proctorsdp/breathStrummer/Screenshots/110_STRUMMER_ISOMETRIC.JPG

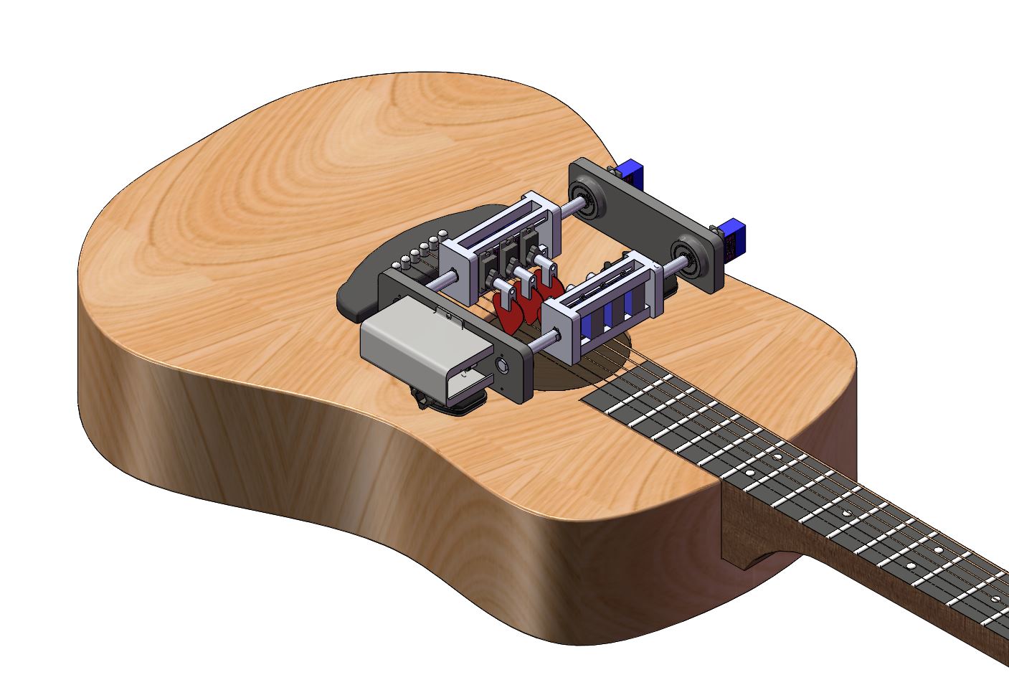
Screenshots/110_STRUMMER_ISOMETRIC.JPG
