proctorsdp/breathStrummer/Screenshots/110_STRUMMER_SIDE_OPAQUE.JPG

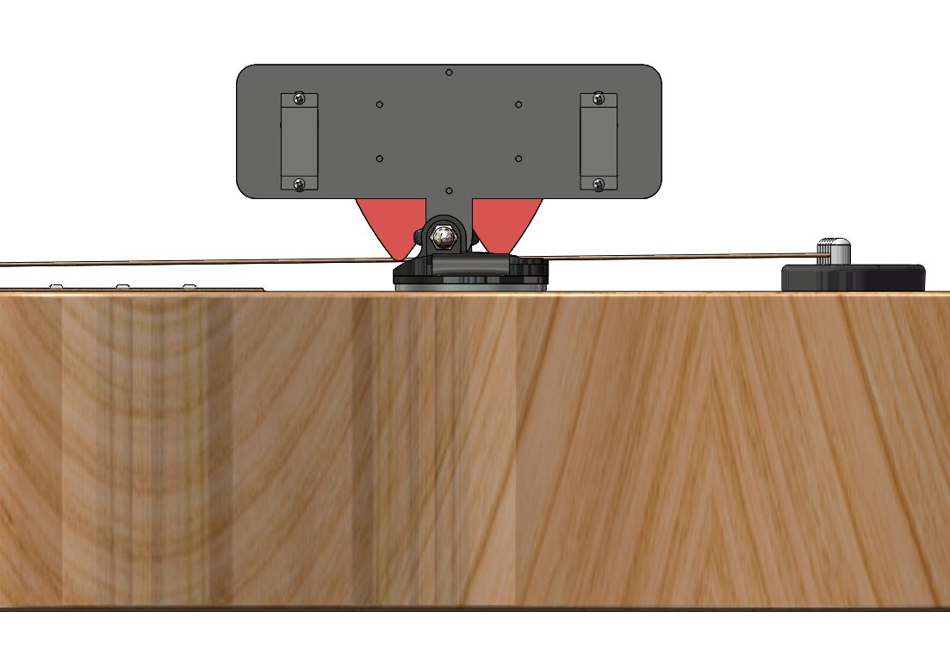
Screenshots/110_STRUMMER_SIDE_OPAQUE.JPG
