proctorsdp/breathStrummer/Drawings/110_STRUMMER_ARRAY_EXPLODED.JPG

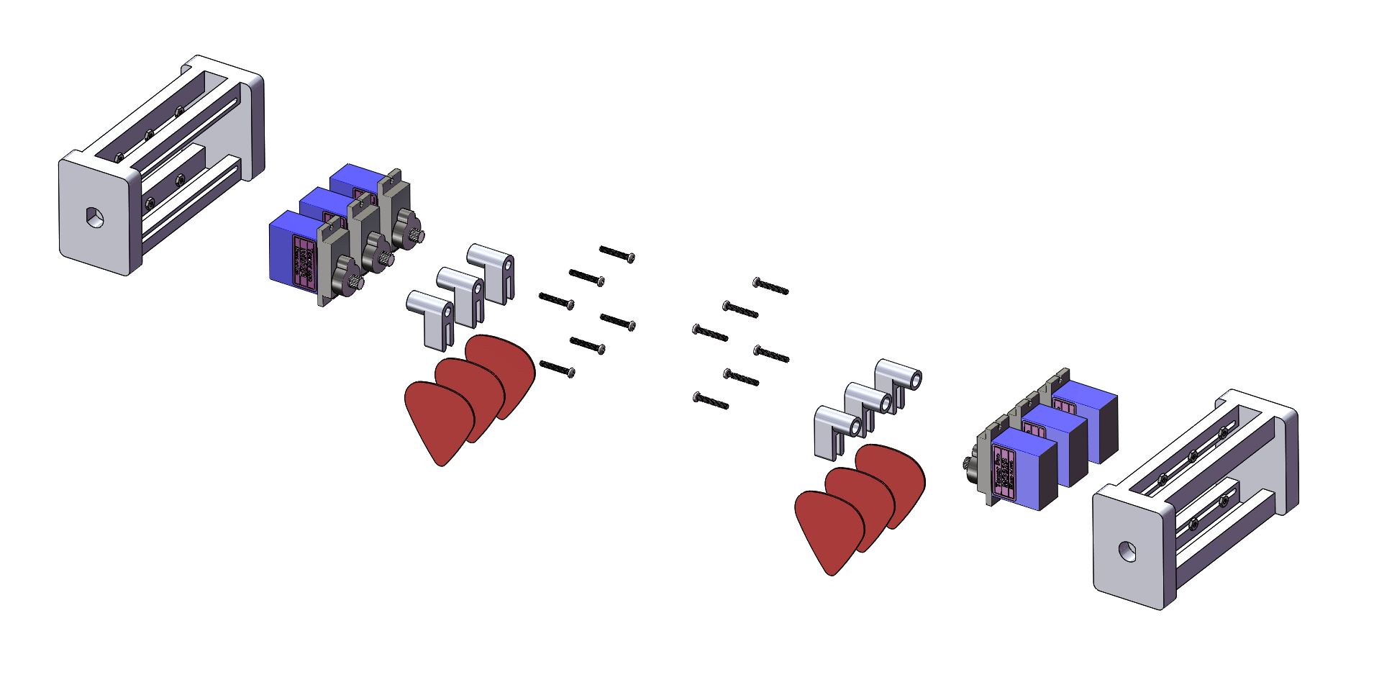
Drawings/110_STRUMMER_ARRAY_EXPLODED.JPG
