proctorsdp/breathStrummer/Drawings/110_STRUMMER_EXPLODED.JPG

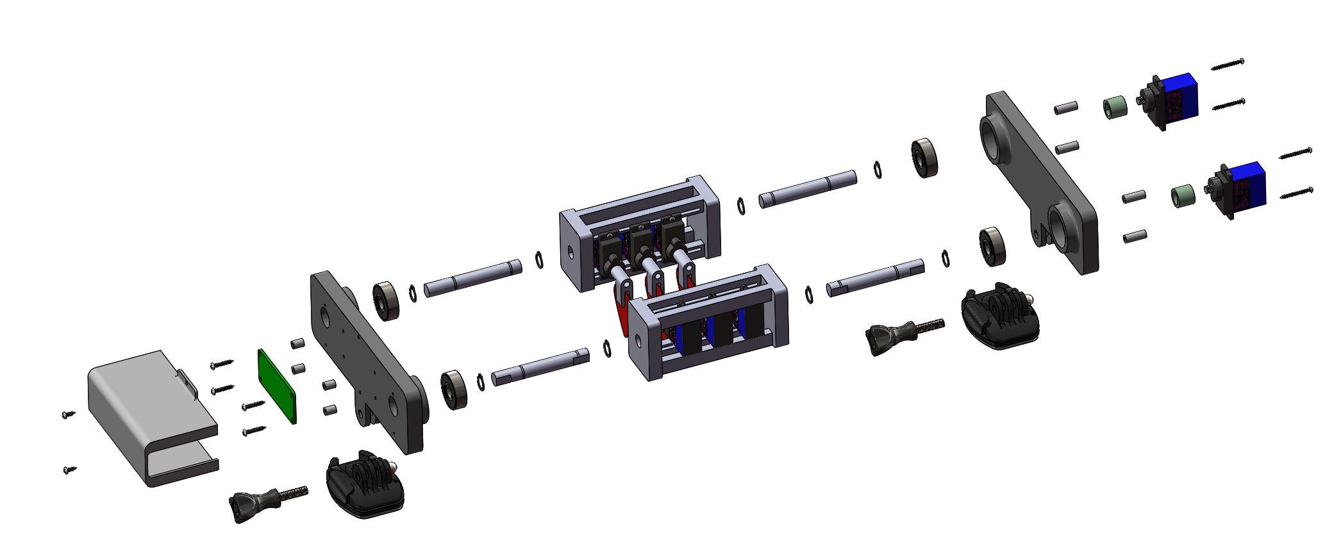
Drawings/110_STRUMMER_EXPLODED.JPG
