proctorsdp/breathStrummer/Drawings/120_MOUTHPIECE_EXPLODED.JPG

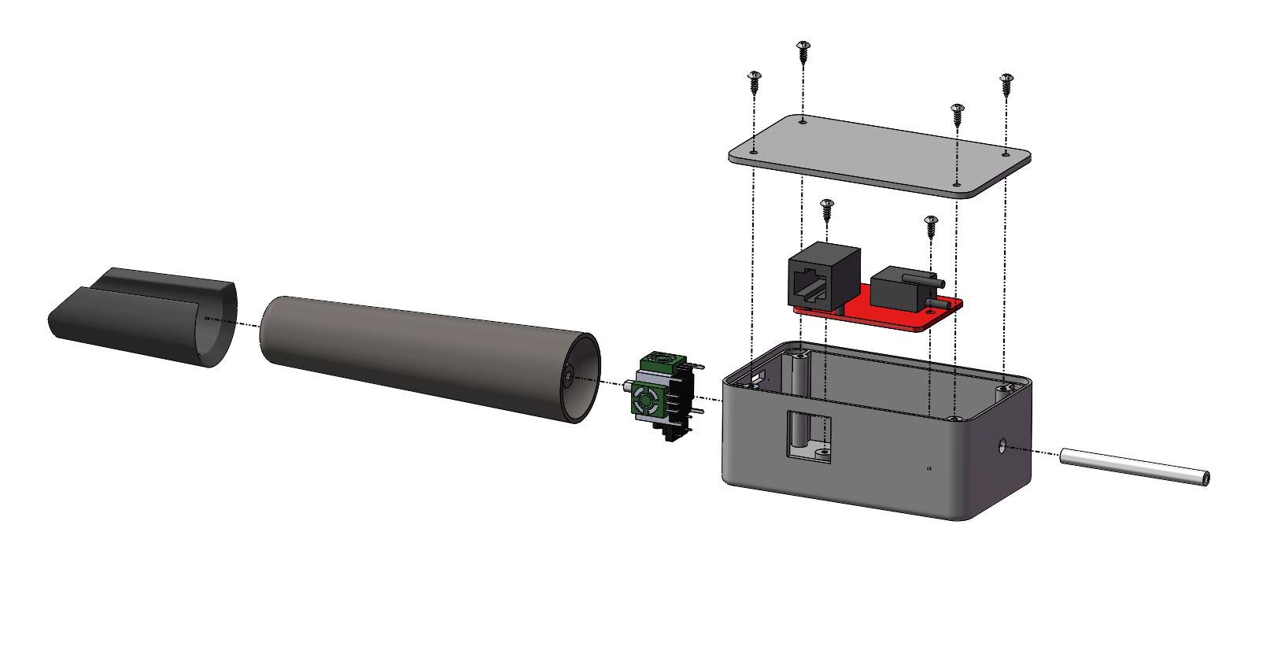
Drawings/120_MOUTHPIECE_EXPLODED.JPG
