proctorsdp/breathStrummer/Screenshots/110_STRUMMER_ISOMETRIC_CLOSE_UP.JPG

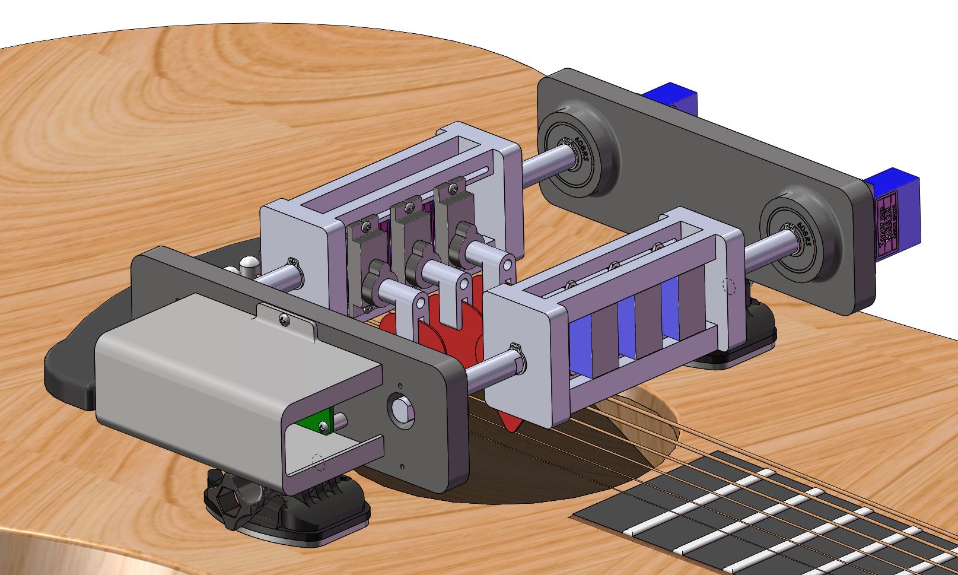
Screenshots/110_STRUMMER_ISOMETRIC_CLOSE_UP.JPG
