proctorsdp/breathStrummer/Screenshots/110_STRUMMER_SIDE_TRANSPARENT.JPG

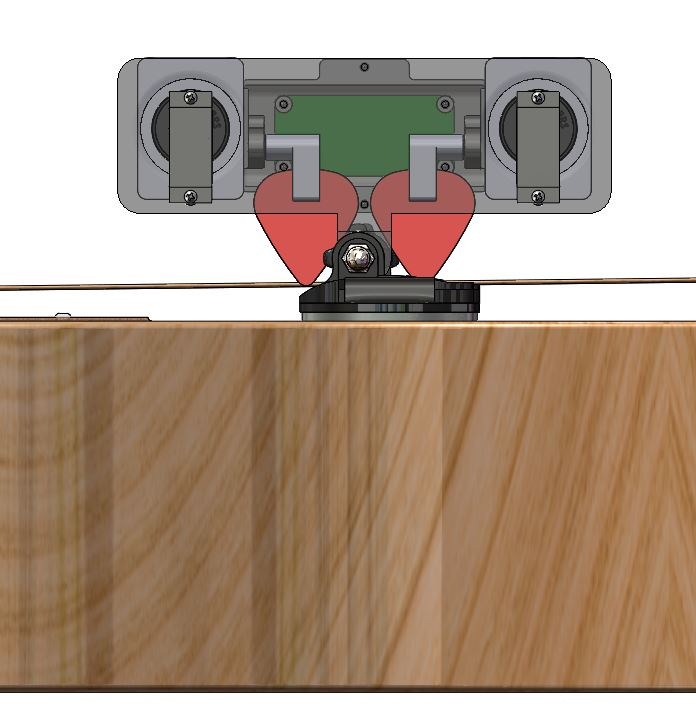
Screenshots/110_STRUMMER_SIDE_TRANSPARENT.JPG
