proctorsdp/breathStrummer/Screenshots/111_LEG_SUPPORT_ISOMETRIC.JPG

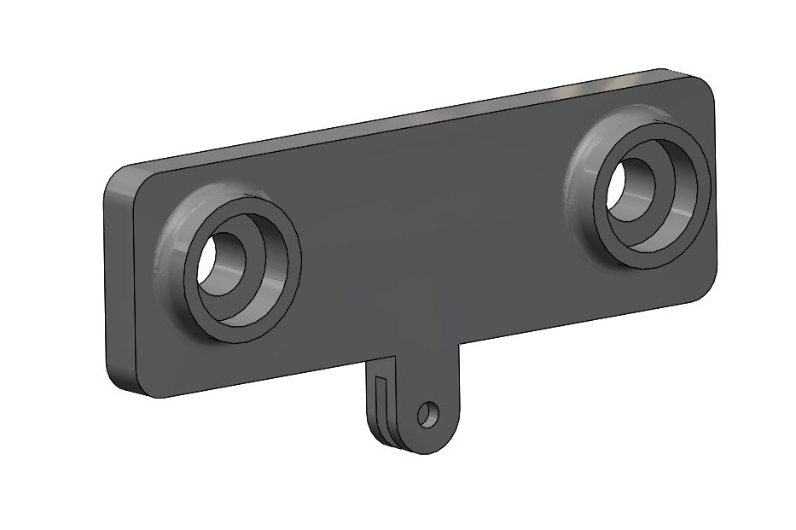
Screenshots/111_LEG_SUPPORT_ISOMETRIC.JPG
