proctorsdp/breathStrummer/Screenshots/112_LEG_SUPPORT_ISOMETRIC.JPG

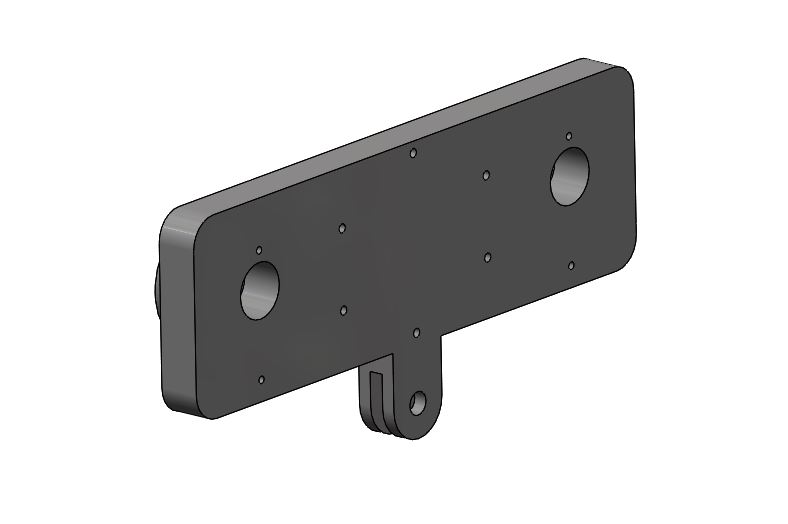
Screenshots/112_LEG_SUPPORT_ISOMETRIC.JPG
