proctorsdp/breathStrummer/Screenshots/113_SERVO_ARRAY_ISOMETRIC.JPG

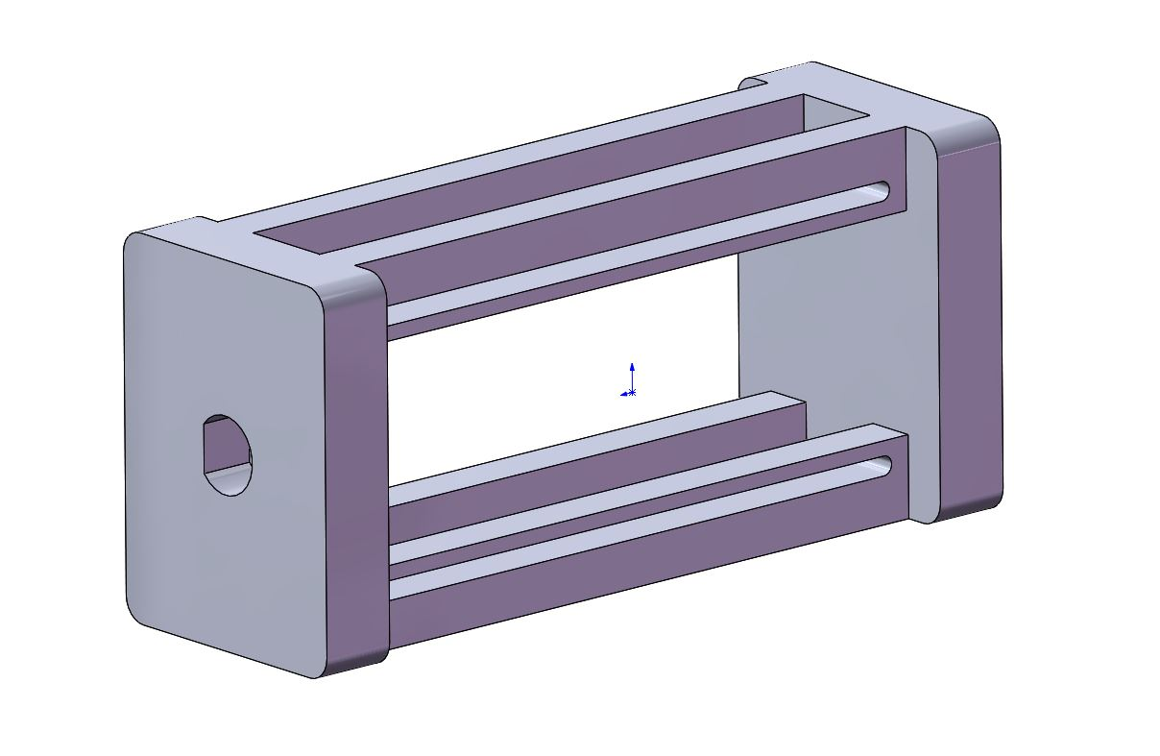
Screenshots/113_SERVO_ARRAY_ISOMETRIC.JPG
