proctorsdp/breathStrummer/Screenshots/114_PICK_HOLDER_ISOMETRIC.JPG

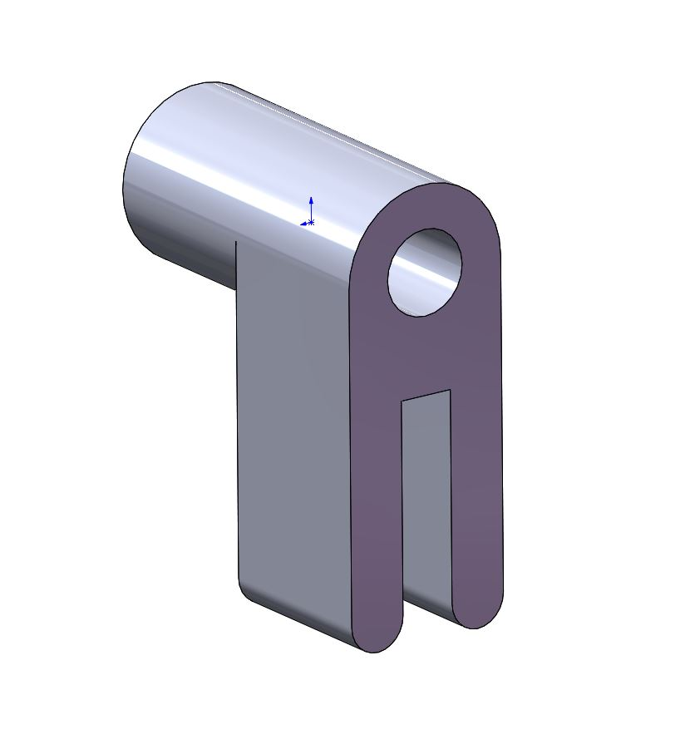
Screenshots/114_PICK_HOLDER_ISOMETRIC.JPG
