proctorsdp/breathStrummer/Screenshots/115_D_SHAFT_ISOMETRIC.JPG

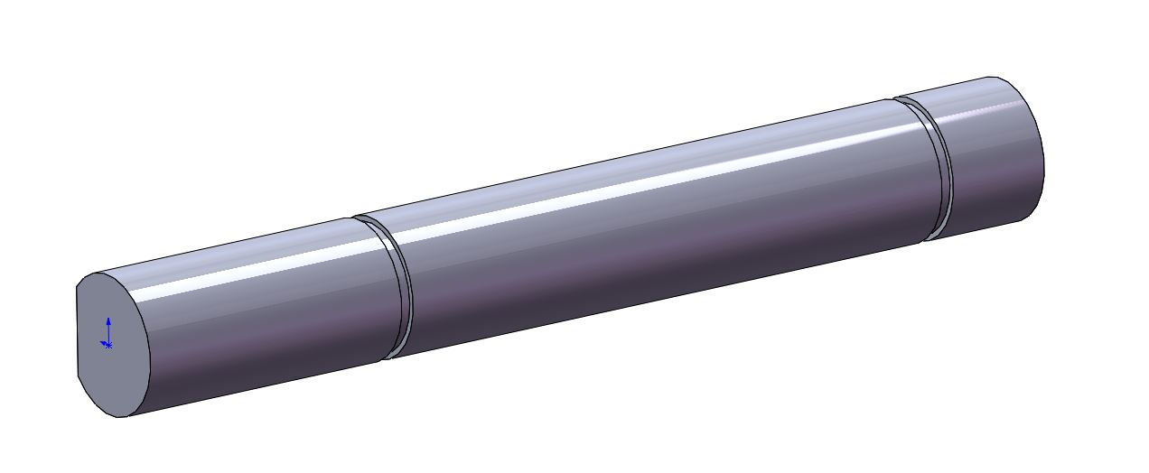
Screenshots/115_D_SHAFT_ISOMETRIC.JPG
