proctorsdp/breathStrummer/Screenshots/116_COVER_MICROPROCESSOR.JPG

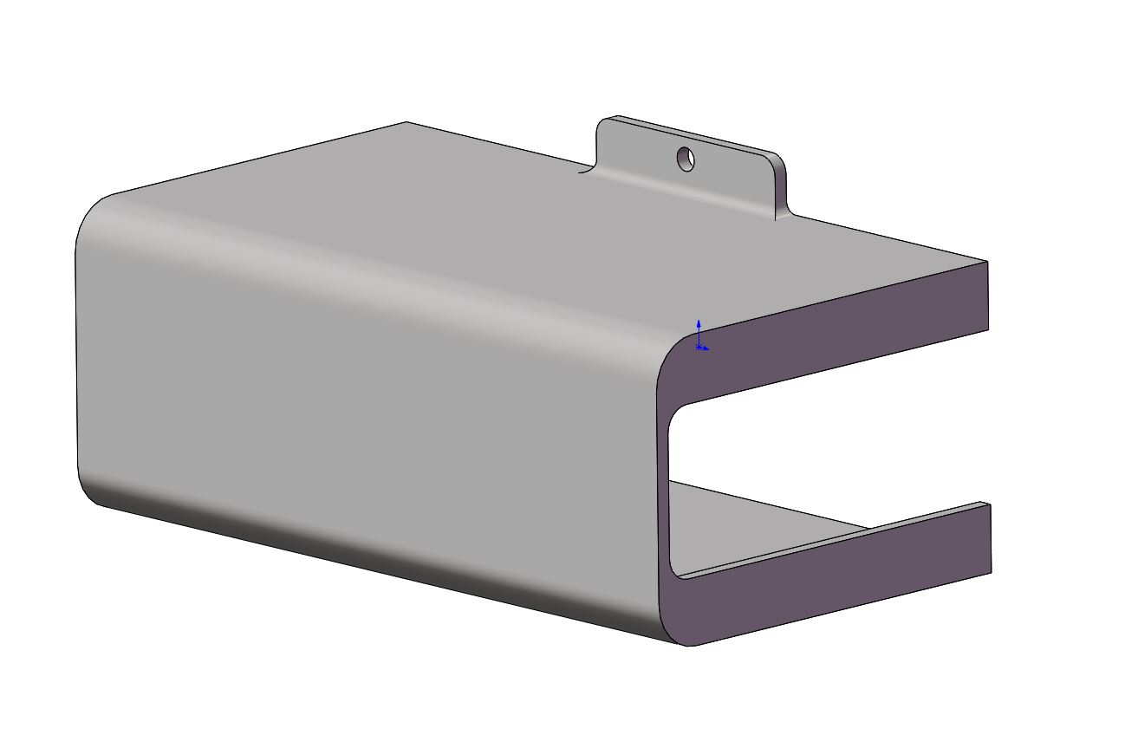
Screenshots/116_COVER_MICROPROCESSOR.JPG
