proctorsdp/breathStrummer/Screenshots/117_ROD_ADAPTER.JPG

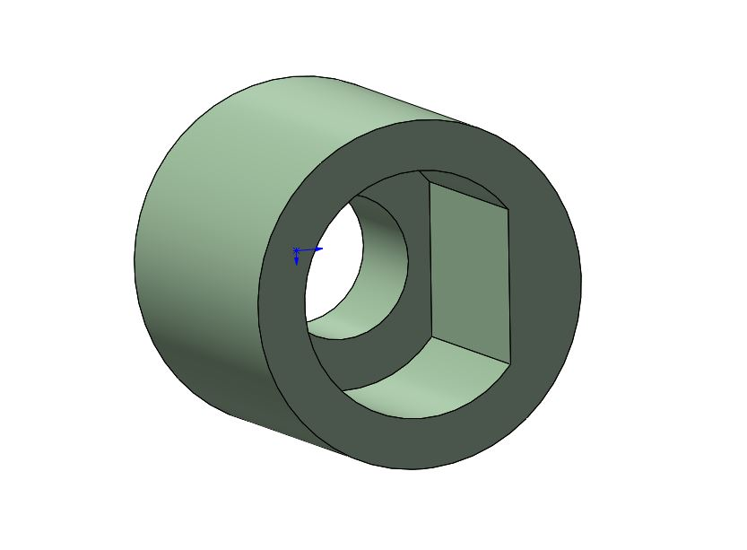
Screenshots/117_ROD_ADAPTER.JPG
