proctorsdp/breathStrummer/Screenshots/120_MOUTHPIECE_ISOMETRIC.JPG

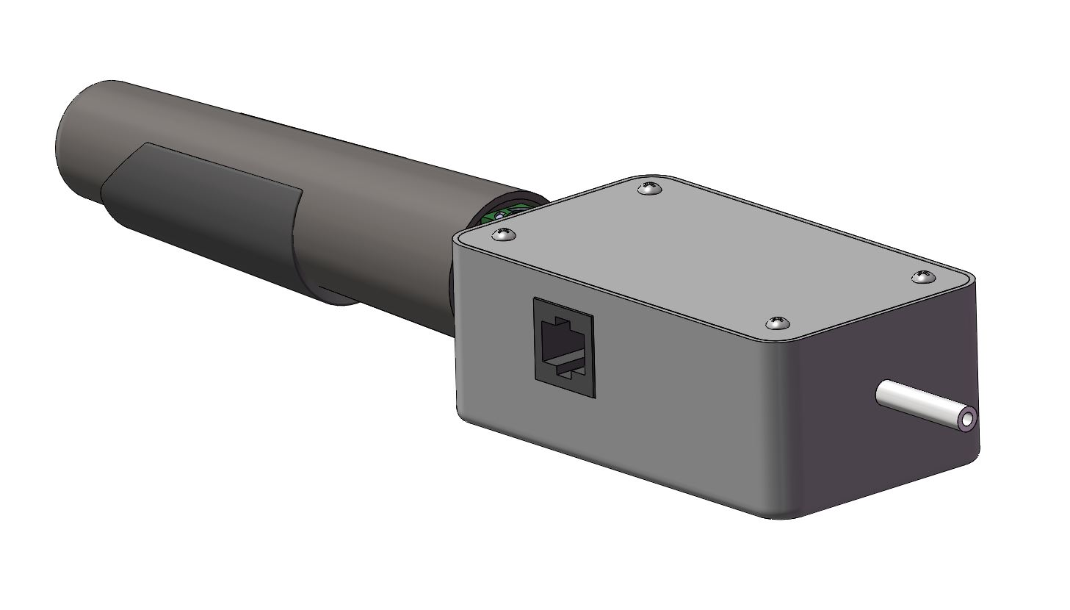
Screenshots/120_MOUTHPIECE_ISOMETRIC.JPG
