proctorsdp/breathStrummer/Screenshots/120_MOUTHPIECE_ISOMETRIC_TRANPARENT.JPG

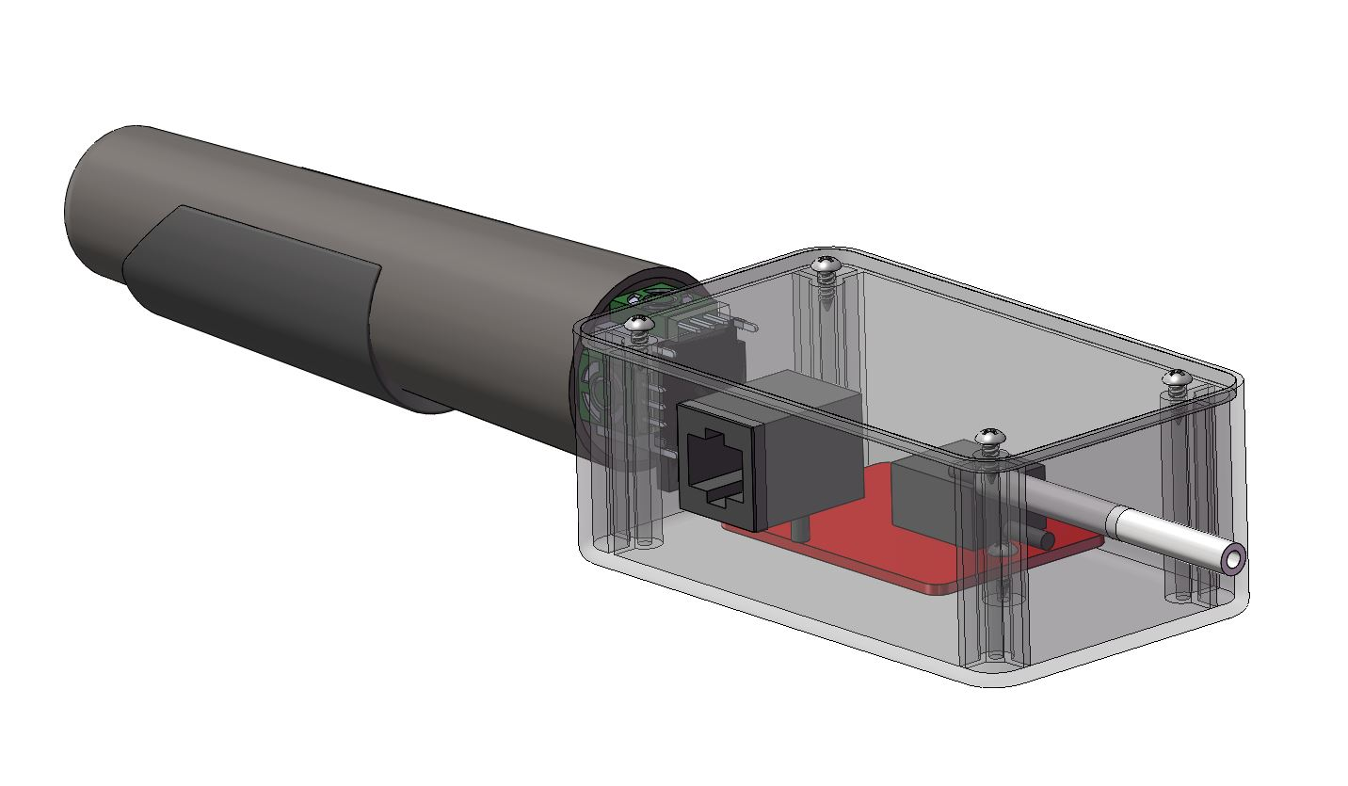
Screenshots/120_MOUTHPIECE_ISOMETRIC_TRANPARENT.JPG
