proctorsdp/breathStrummer/Screenshots/120_MOUTHPIECE_SIDE_TRANSPARENT.JPG

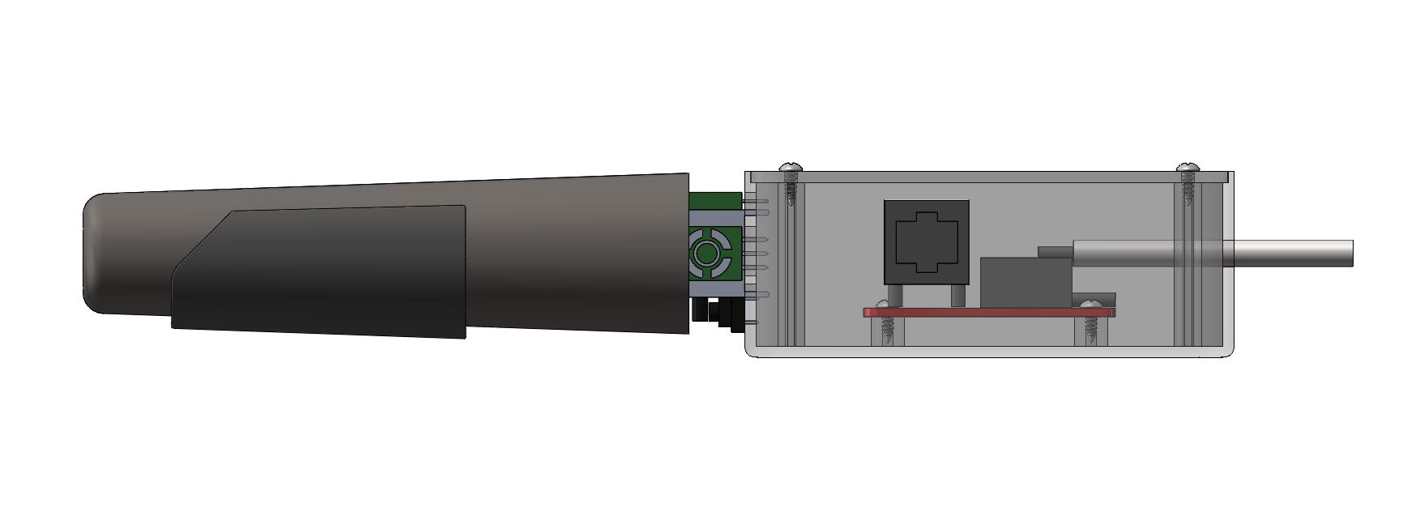
Screenshots/120_MOUTHPIECE_SIDE_TRANSPARENT.JPG
