proctorsdp/breathStrummer/Screenshots/121_HOUSING_BASE.JPG

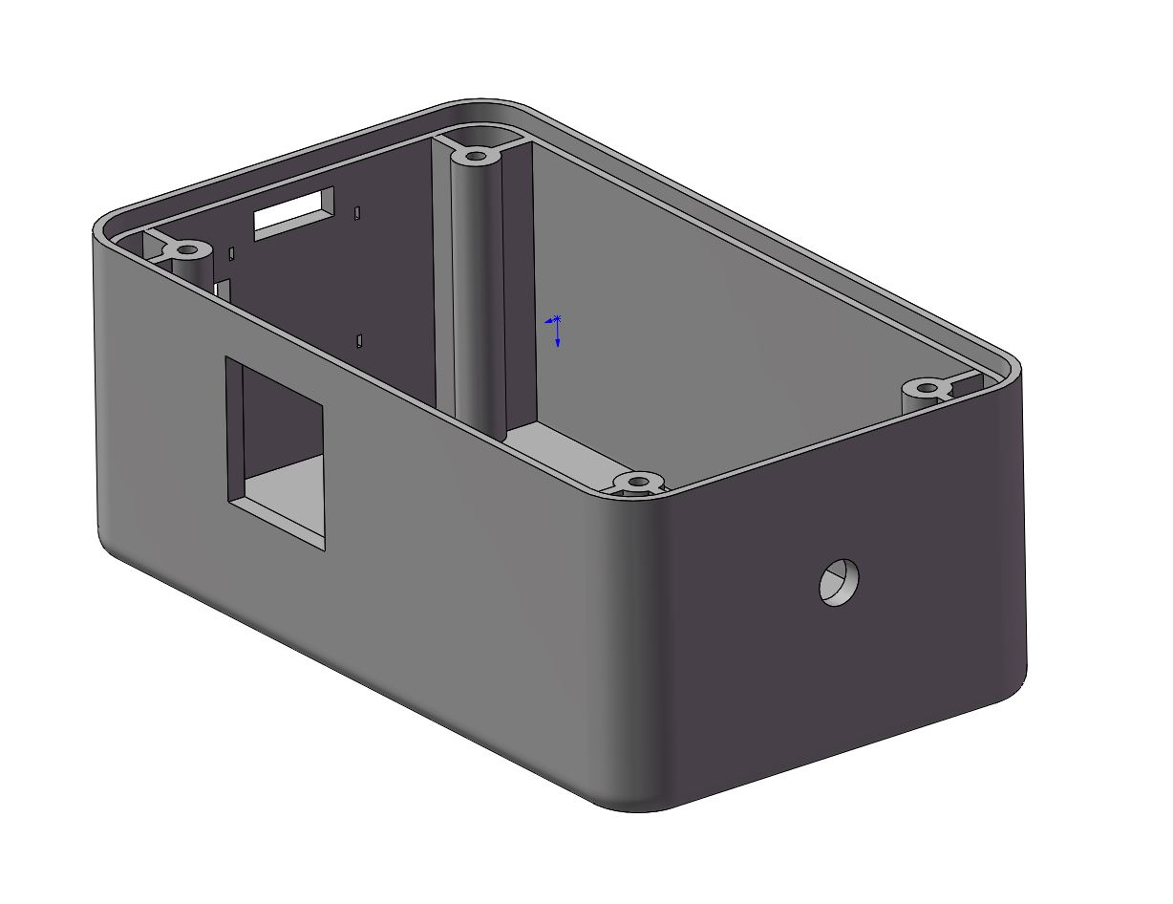
Screenshots/121_HOUSING_BASE.JPG
