proctorsdp/breathStrummer/Screenshots/122_HOUSING_LID.JPG

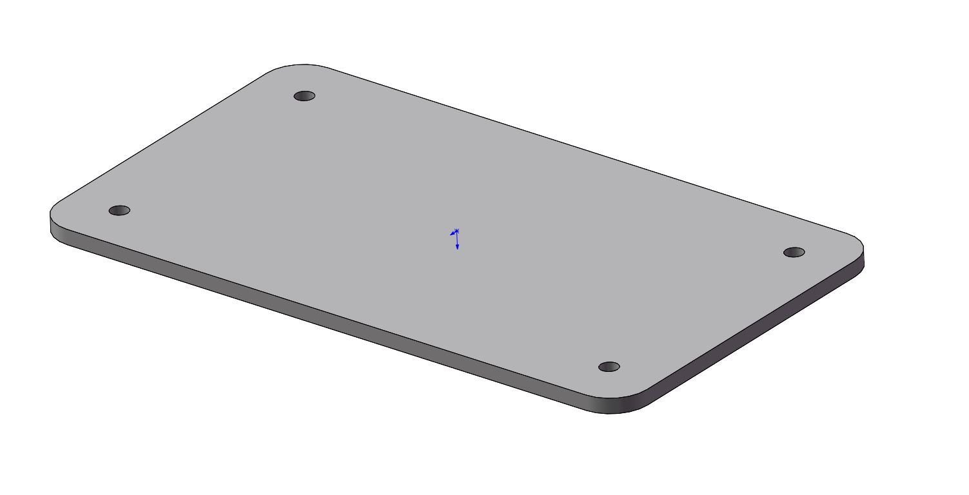
Screenshots/122_HOUSING_LID.JPG
