proctorsdp/breathStrummer/Screenshots/123_MICROPHONE_MOUNT.JPG

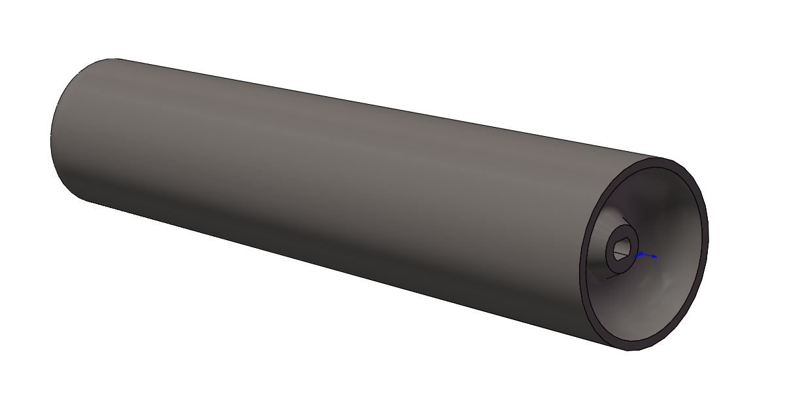
Screenshots/123_MICROPHONE_MOUNT.JPG
