proctorsdp/breathStrummer/Solid Works/Strummer/GoPro_Quick_Release_Buckle.sldasm

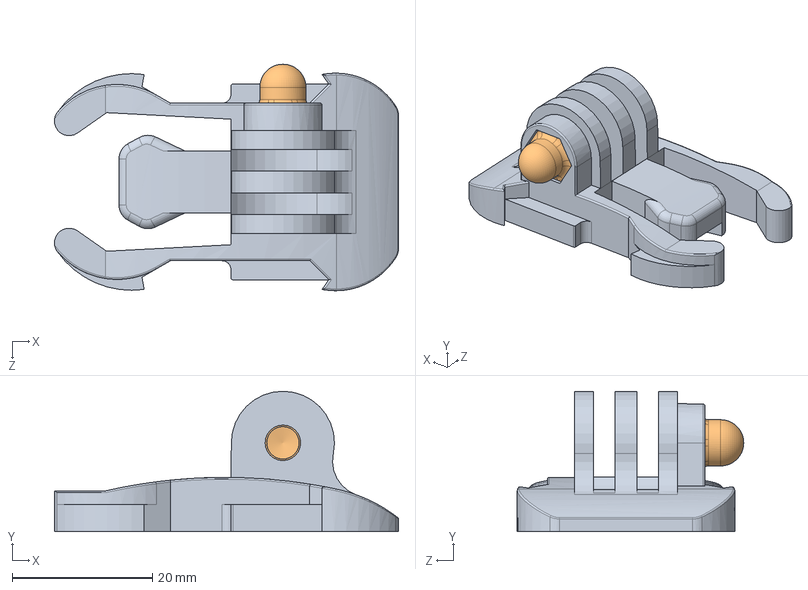
[picture p28: CAD file, 2017-12-18]
Solid Works/Strummer/GoPro_Quick_Release_Buckle.sldasm
49.1 x 20.1 x 32.4 mm
GoPro_Quick_Release_Buckle
GoPro_Nut
