proctorsdp/breathStrummer/Solid Works/Strummer/110_STRUMMER.SLDASM

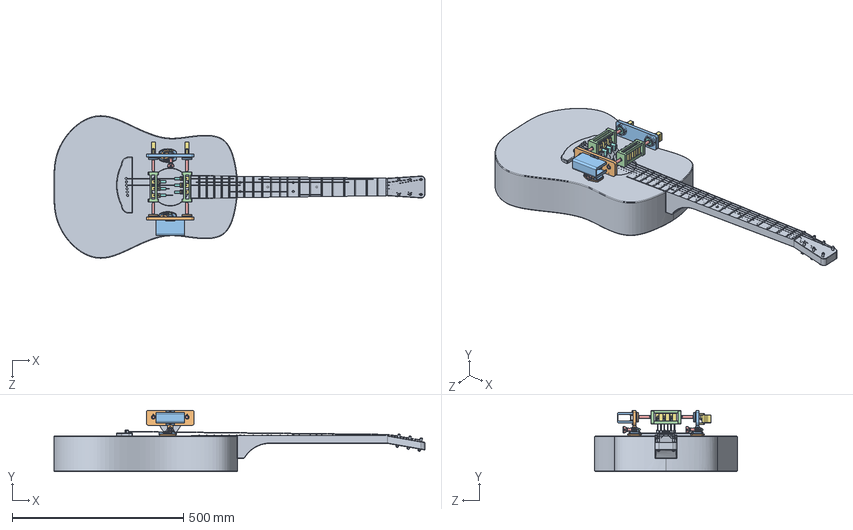
[picture p29: CAD file, 2017-12-18]
Solid Works/Strummer/110_STRUMMER.SLDASM
1082.9 x 179.5 x 416.2 mm
GUITAR_ACOUSTIC
GoPro_Adhesive_Base x 2
GoPro_Quick_Release_Buckle x 2
GoPro_Nut x 2
GoPro_Thumbscrew_Plastic_Short x 2
GoPro_Thumbscrew_Screw_Short x 2
MG92B_servo x 8
114_PICK_HOLDER x 6
GUITAR_PICK_6MM x 6
111_LEG_SUPPORT
112_LEG_SUPPORT
113_SERVO_ARRAY x 2
115_D_SHAFT x 4
91772A070_18-8 SS PAN HEAD PHILLIPS MACHINE SCREW x 12
91841A125_TYPE 18-8 STAINLESS STEEL HEX NUT x 12
SKATEBOARD_BEARING x 4
117_ROD_ADAPTER x 2
ADAFRUIT_FEATHER
116_COVER_MICROPROCESSOR
94639A705_NYLON UNTHRD SPACERS x 4
92470A098_PAN HEAD PHILLIPS SCREW FOR SHEET METAL x 4
92470A065_PAN HEAD PHILLIPS SCREW FOR SHEET METAL x 4
94639A713_NYLON UNTHRD SPACERS x 4
98410A115_EXTERNAL RETAINING RING x 8
92470A095_PAN HEAD PHILLIPS SCREW FOR SHEET METAL x 2
