proctorsdp/breathStrummer/Solid Works/Mouthpiece/MICROPHONE_CLIP.SLDPRT

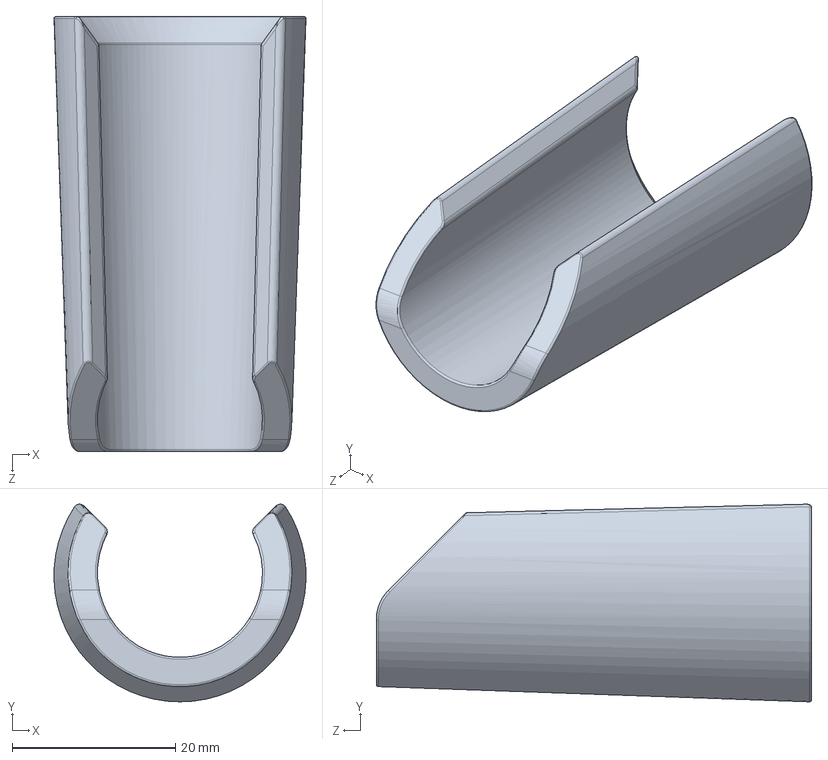
[picture p30: CAD file, 2017-12-18]
Solid Works/Mouthpiece/MICROPHONE_CLIP.SLDPRT
30.9 x 24.3 x 53.4 mm
