proctorsdp/breathStrummer/STL Files/Mouthpiece/122_HOUSING_LID.STL

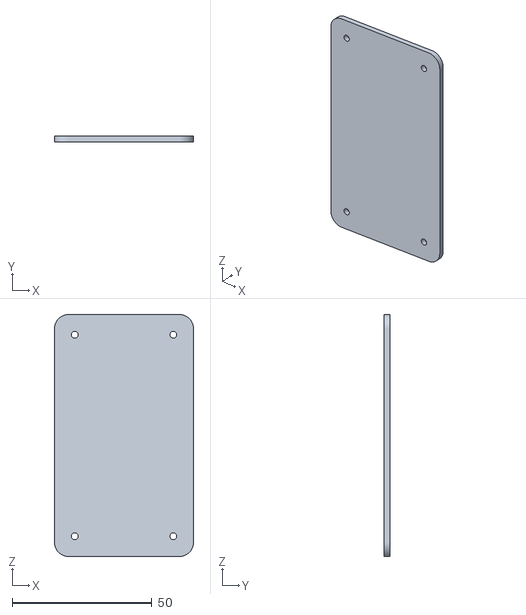
[picture p31: CAD file, 2017-12-18]
STL Files/Mouthpiece/122_HOUSING_LID.STL
49.8 x 2.03 x 86.6
