proctorsdp/breathStrummer/STL Files/Strummer/112_LEG_SUPPORT.STL

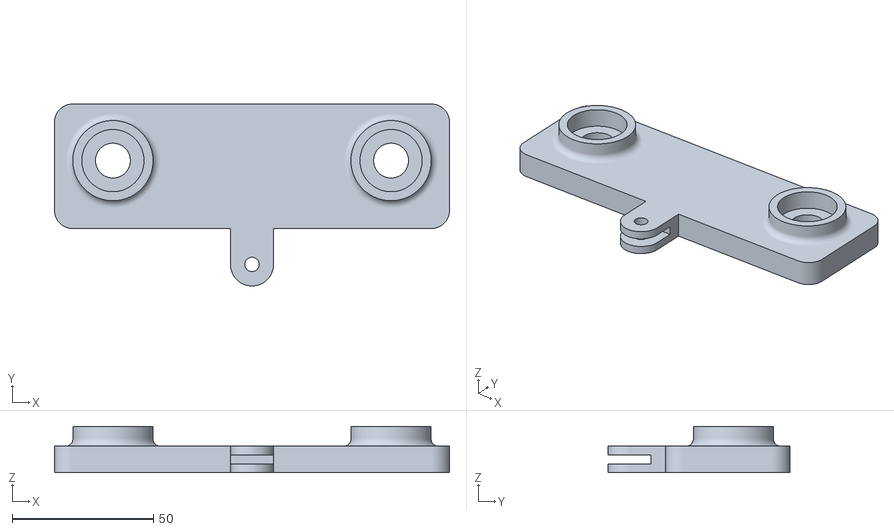
[picture p32: CAD file, 2017-12-18]
STL Files/Strummer/112_LEG_SUPPORT.STL
139.7 x 64.3 x 16.3
