proctorsdp/breathStrummer/Solid Works/Mouthpiece/TUBE.SLDPRT

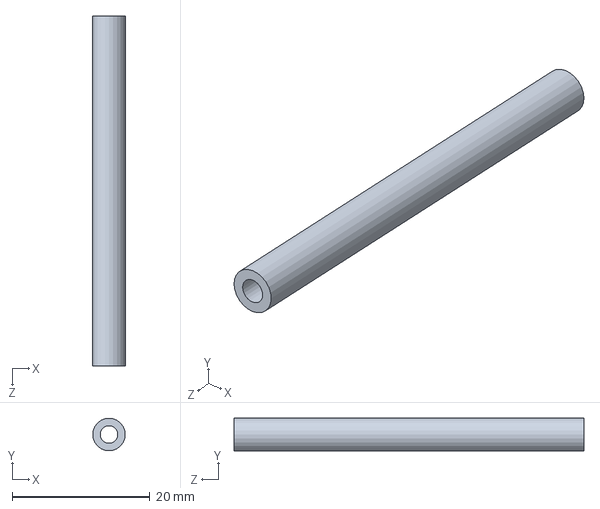
[picture p33: CAD file, 2017-12-18]
Solid Works/Mouthpiece/TUBE.SLDPRT
4.72 x 4.72 x 50.8 mm
