proctorsdp/breathStrummer/Solid Works/Strummer/GUITAR_PICK_6MM.SLDPRT

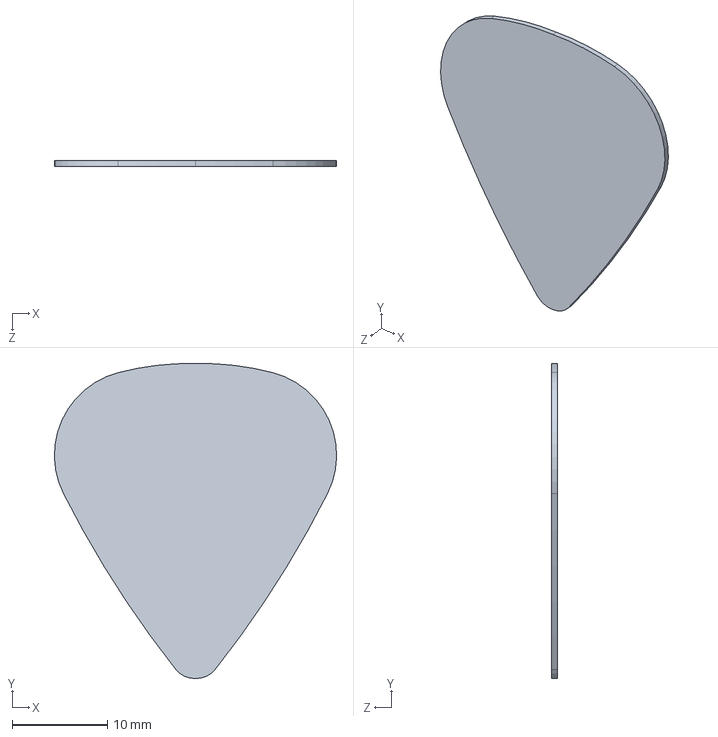
[picture p34: CAD file, 2017-12-18]
Solid Works/Strummer/GUITAR_PICK_6MM.SLDPRT
29.6 x 33.0 x 0.6 mm
