proctorsdp/breathStrummer/STL Files/Mouthpiece/121_HOUSING_BASE.STL

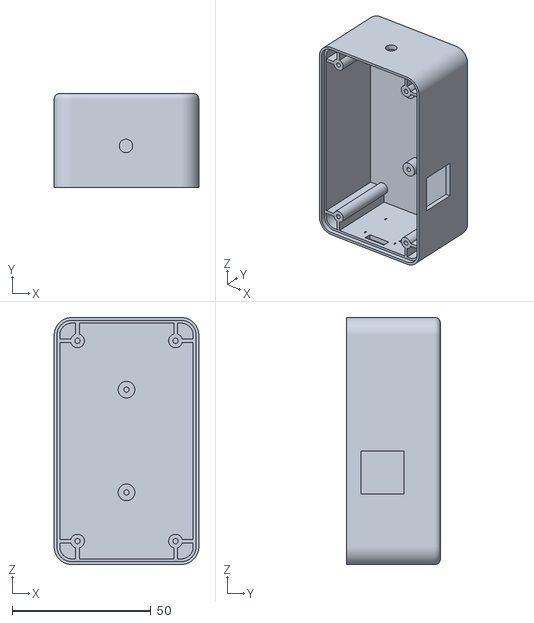
[picture p35: CAD file, 2017-12-18]
STL Files/Mouthpiece/121_HOUSING_BASE.STL
52.1 x 33.8 x 88.9
