proctorsdp/breathStrummer/STL Files/Strummer/114_PICK_HOLDER.STL

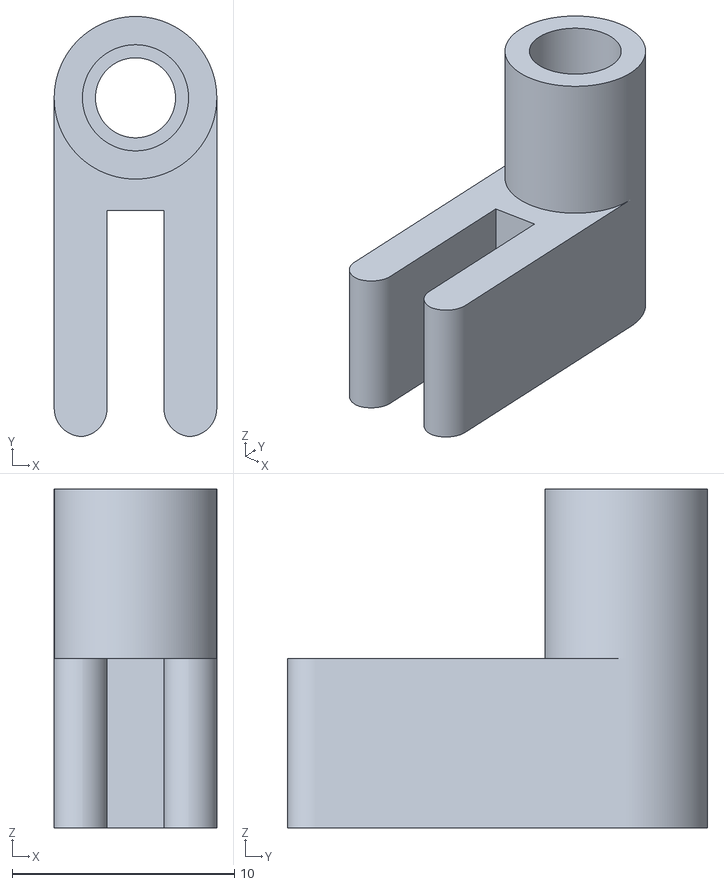
[picture p36: CAD file, 2017-12-18]
STL Files/Strummer/114_PICK_HOLDER.STL
7.32 x 18.9 x 15.2
