proctorsdp/breathStrummer/Solid Works/Mouthpiece/122_HOUSING_LID.SLDPRT

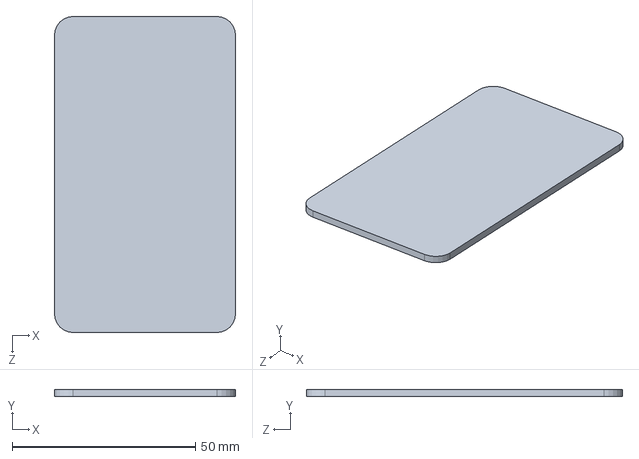
[picture p37: CAD file, 2017-12-18]
Solid Works/Mouthpiece/122_HOUSING_LID.SLDPRT
49.4 x 2.03 x 86.2 mm
