proctorsdp/breathStrummer/STL Files/Mouthpiece/123_MICROPHONE_MOUNT.STL

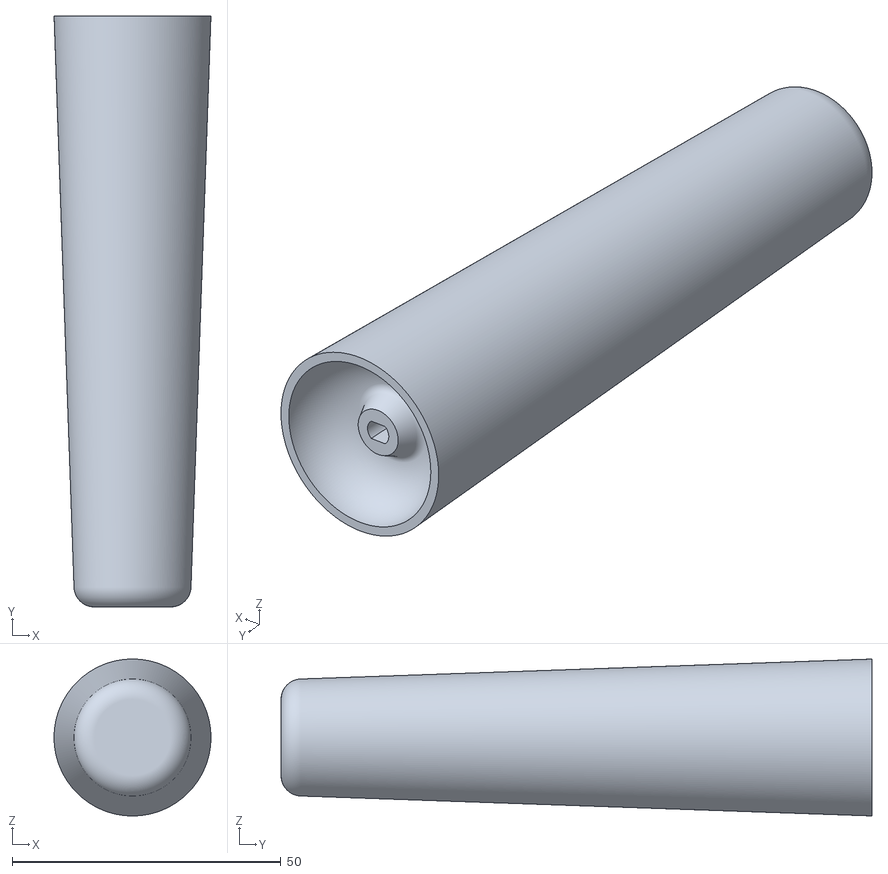
[picture p38: CAD file, 2017-12-18]
STL Files/Mouthpiece/123_MICROPHONE_MOUNT.STL
29.2 x 110.0 x 29.2
