proctorsdp/breathStrummer/STL Files/Strummer/113_SERVO_ARRAY.STL

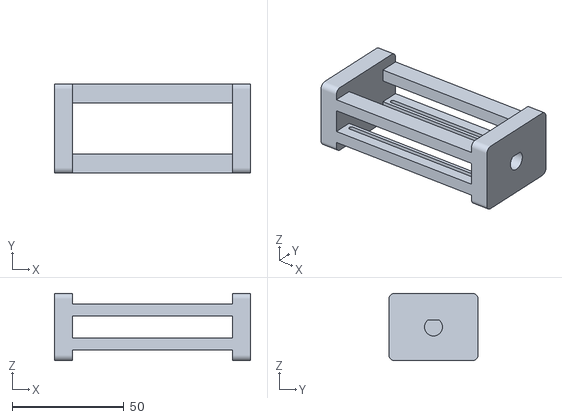
[picture p39: CAD file, 2017-12-18]
STL Files/Strummer/113_SERVO_ARRAY.STL
87.6 x 40.0 x 30.0
