proctorsdp/breathStrummer/Solid Works/Mouthpiece/HONEYWELL_001PDAA5.SLDPRT

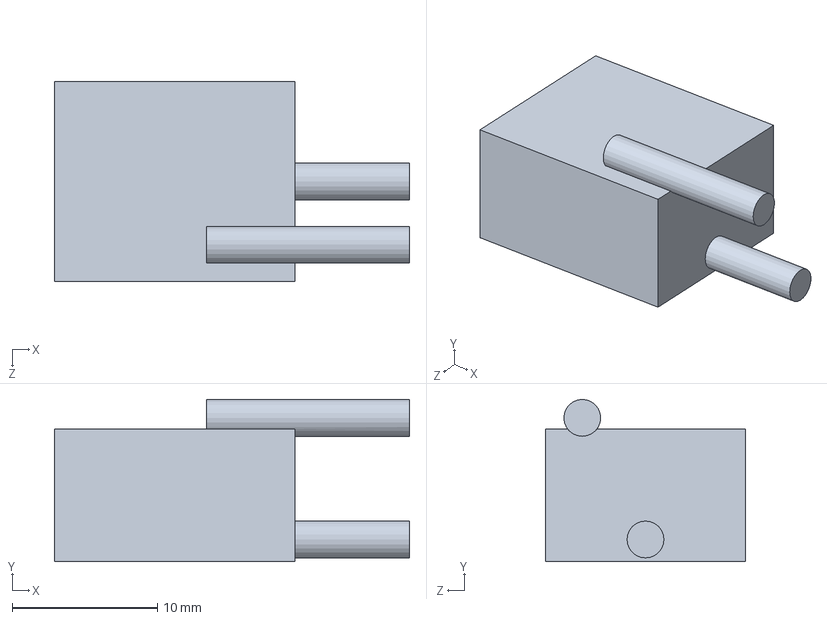
[picture p40: CAD file, 2017-12-18]
Solid Works/Mouthpiece/HONEYWELL_001PDAA5.SLDPRT
24.5 x 11.2 x 13.8 mm
