proctorsdp/breathStrummer/STL Files/Strummer/116_COVER_MICROPROCESSOR.STL

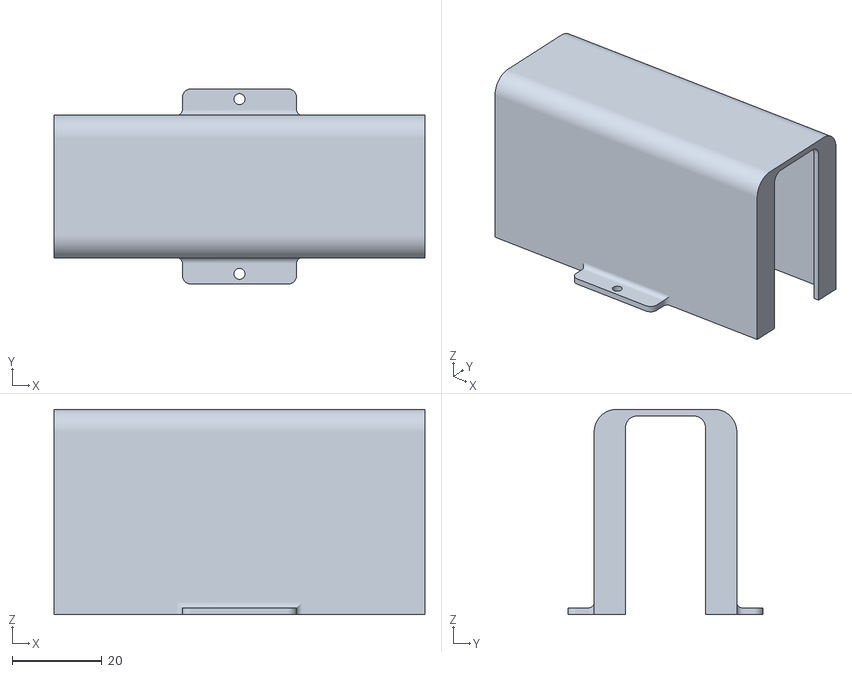
[picture p41: CAD file, 2017-12-18]
STL Files/Strummer/116_COVER_MICROPROCESSOR.STL
82.5 x 43.4 x 45.7
