proctorsdp/breathStrummer/Solid Works/Mouthpiece/9032_JOYSTICK_POTENTIOMETER.SLDPRT

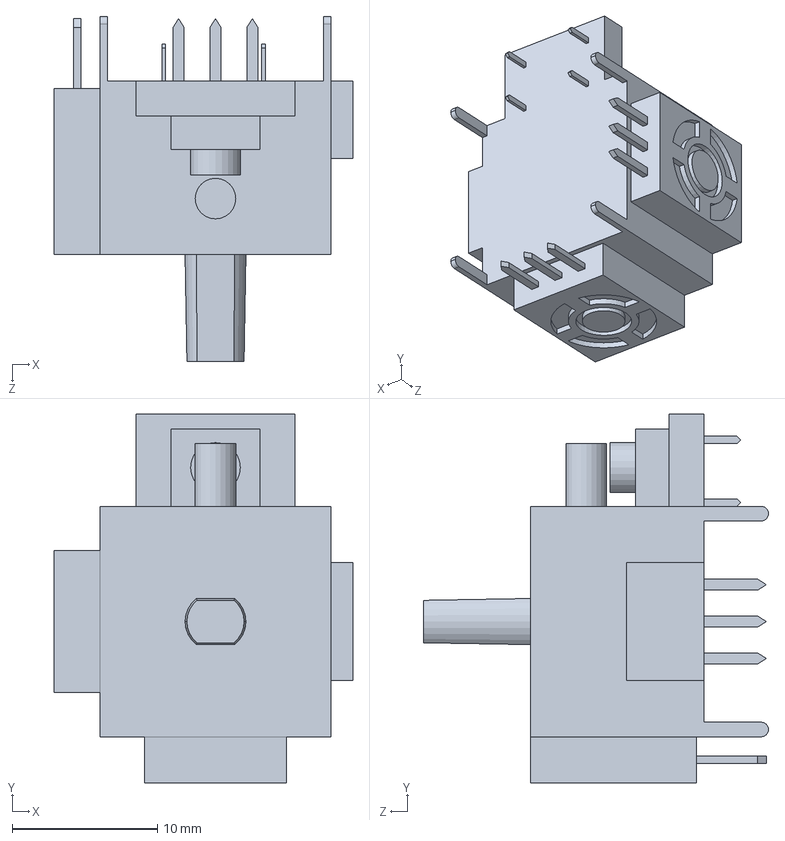
[picture p42: CAD file, 2017-12-18]
Solid Works/Mouthpiece/9032_JOYSTICK_POTENTIOMETER.SLDPRT
20.6 x 25.4 x 23.7 mm
