proctorsdp/breathStrummer/STL Files/Strummer/117_ROD_ADAPTER.STL

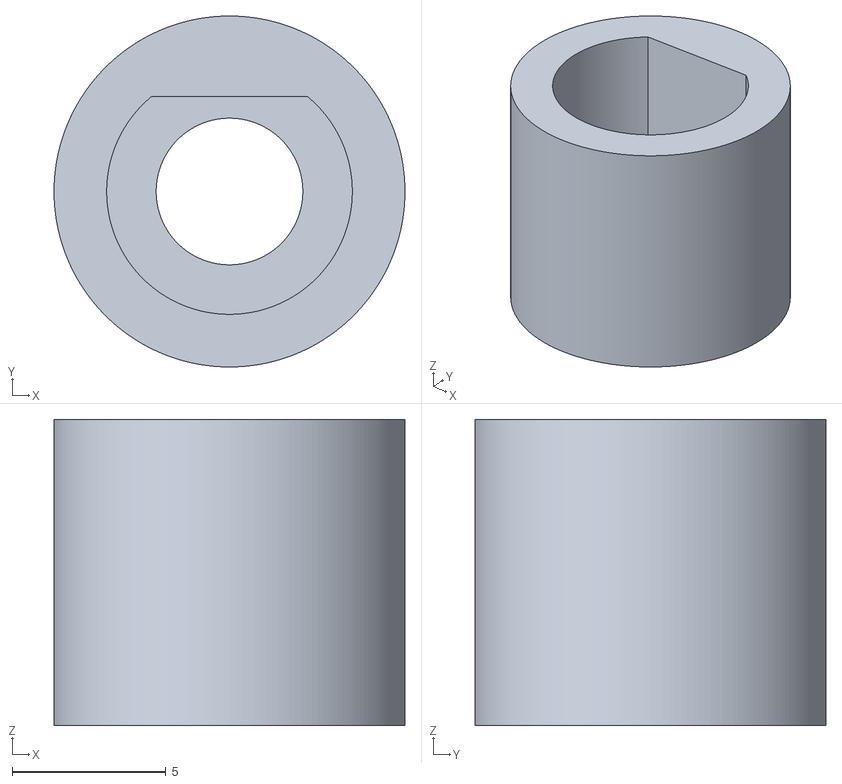
[picture p43: CAD file, 2017-12-18]
STL Files/Strummer/117_ROD_ADAPTER.STL
11.4 x 11.4 x 9.97
