proctorsdp/breathStrummer/Solid Works/Mouthpiece/RJ45.SLDPRT

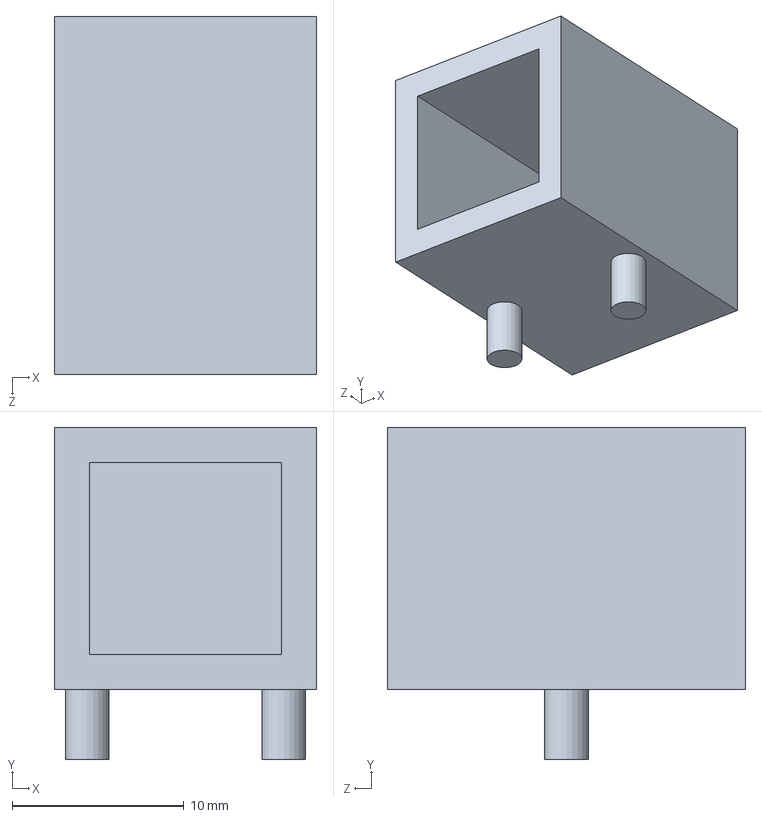
[picture p44: CAD file, 2017-12-18]
Solid Works/Mouthpiece/RJ45.SLDPRT
15.2 x 19.3 x 20.8 mm
