proctorsdp/breathStrummer/Solid Works/Mouthpiece/BOARD_INPUT_DEVICE.SLDPRT

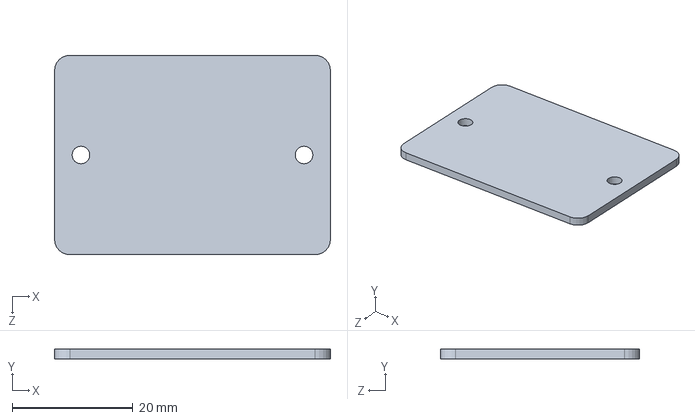
[picture p45: CAD file, 2017-12-18]
Solid Works/Mouthpiece/BOARD_INPUT_DEVICE.SLDPRT
45.7 x 1.57 x 33.0 mm
