proctorsdp/breathStrummer/Solid Works/Strummer/113_SERVO_ARRAY.SLDPRT

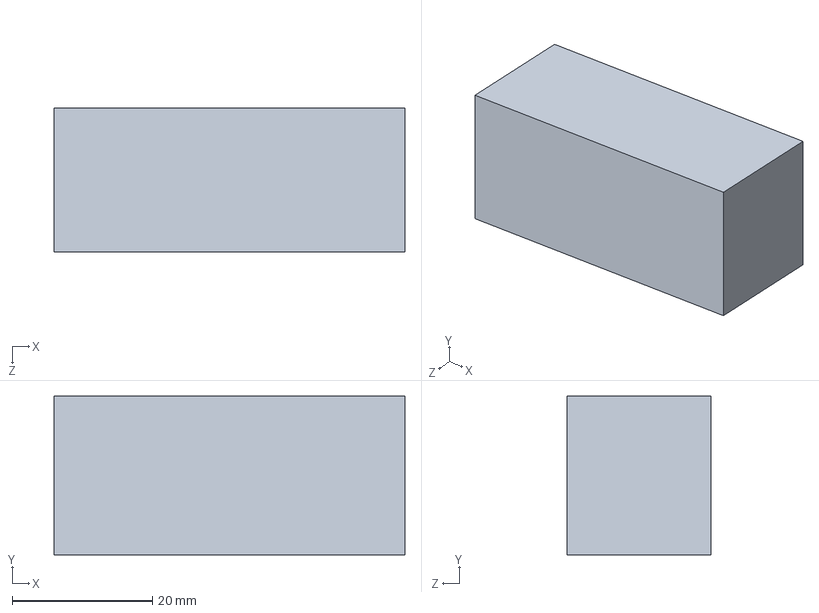
[picture p46: CAD file, 2017-12-18]
Solid Works/Strummer/113_SERVO_ARRAY.SLDPRT
50.0 x 22.6 x 20.5 mm
