proctorsdp/breathStrummer/Solid Works/Strummer/GoPro_Adhesive_Base.SLDPRT

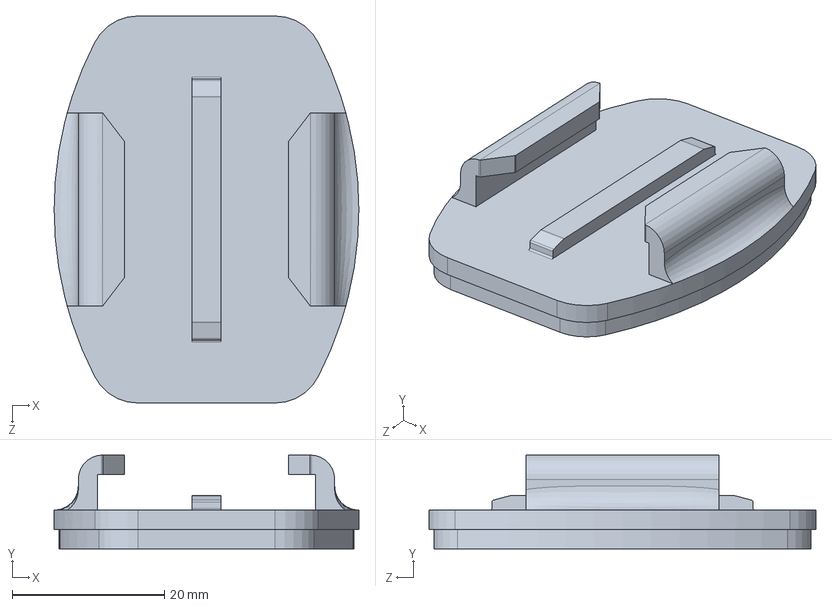
[picture p47: CAD file, 2017-12-18]
Solid Works/Strummer/GoPro_Adhesive_Base.SLDPRT
40.0 x 12.3 x 50.8 mm
