proctorsdp/breathStrummer/Solid Works/Strummer/112_LEG_SUPPORT.SLDPRT

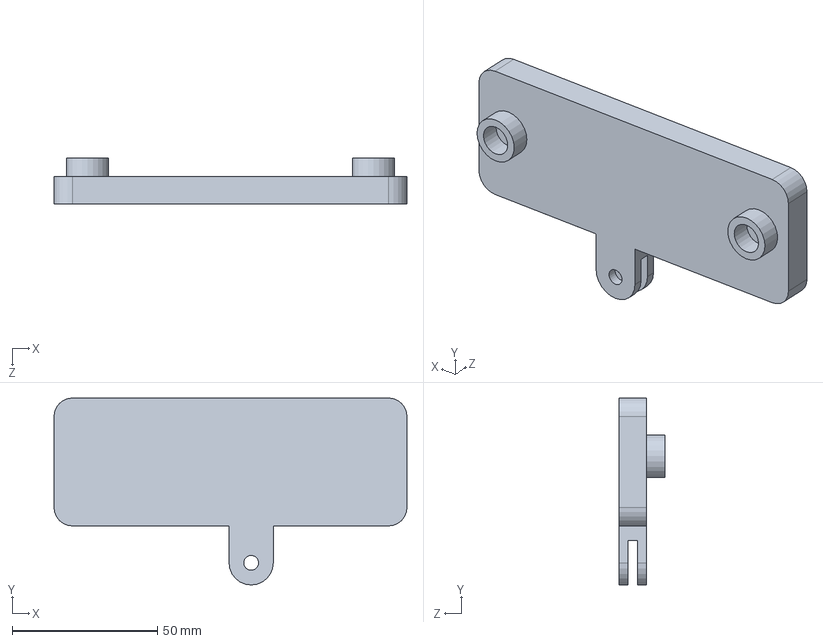
[picture p48: CAD file, 2017-12-18]
Solid Works/Strummer/112_LEG_SUPPORT.SLDPRT
121.4 x 64.3 x 15.7 mm
