proctorsdp/breathStrummer/Solid Works/Strummer/SKATEBOARD_BEARING.SLDPRT

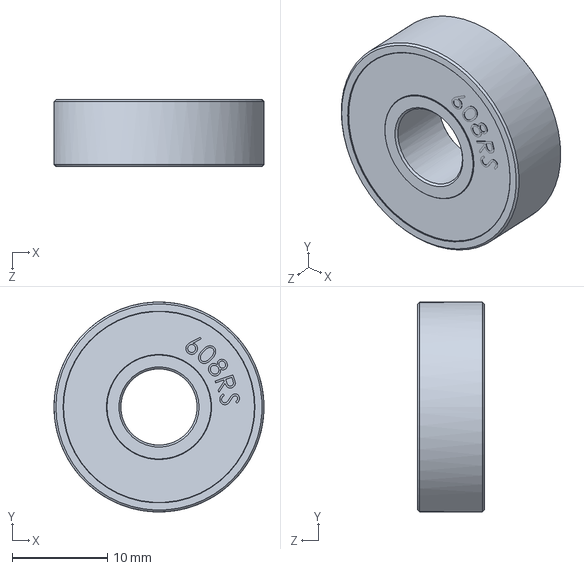
[picture p49: CAD file, 2017-12-18]
Solid Works/Strummer/SKATEBOARD_BEARING.SLDPRT
22.0 x 22.0 x 7.00 mm
