proctorsdp/breathStrummer/Solid Works/Strummer/MG92B_servo.SLDPRT

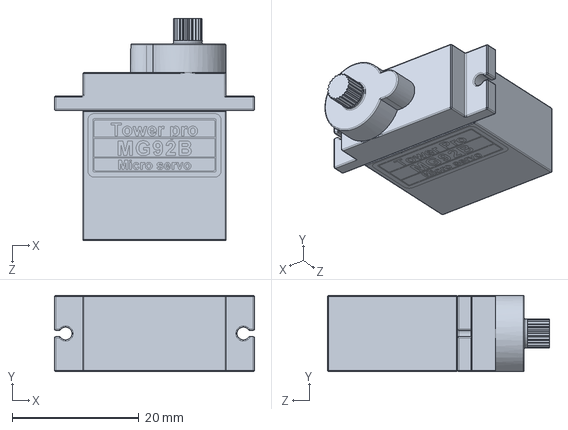
[picture p50: CAD file, 2017-12-18]
Solid Works/Strummer/MG92B_servo.SLDPRT
31.5 x 12.0 x 35.0 mm
