proctorsdp/breathStrummer/Solid Works/Strummer/115_D_SHAFT.SLDPRT

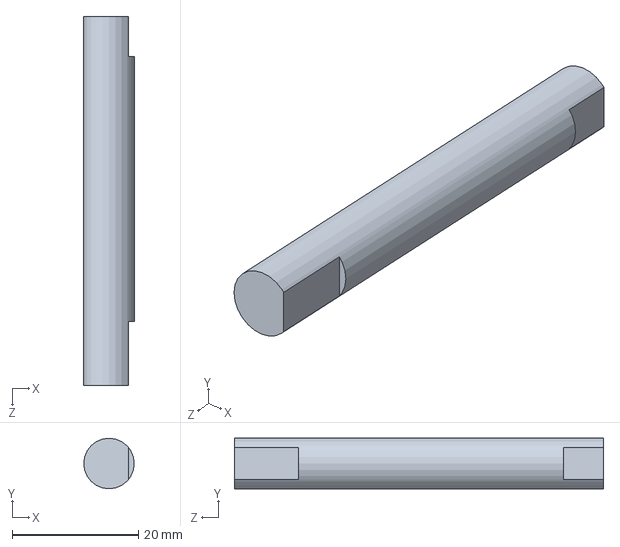
[picture p51: CAD file, 2017-12-18]
Solid Works/Strummer/115_D_SHAFT.SLDPRT
8.00 x 8.00 x 58.4 mm
