proctorsdp/breathStrummer/Solid Works/Strummer/111_LEG_SUPPORT.SLDPRT

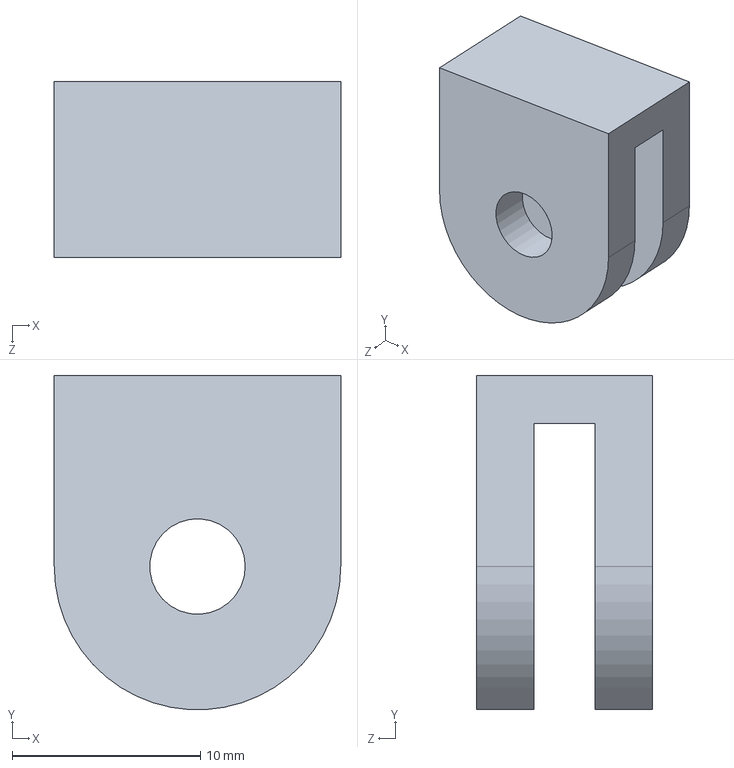
[picture p52: CAD file, 2017-12-18]
Solid Works/Strummer/111_LEG_SUPPORT.SLDPRT
15.2 x 17.8 x 9.35 mm
