proctorsdp/breathStrummer/Solid Works/Strummer/GUITAR_ACOUSTIC.SLDPRT

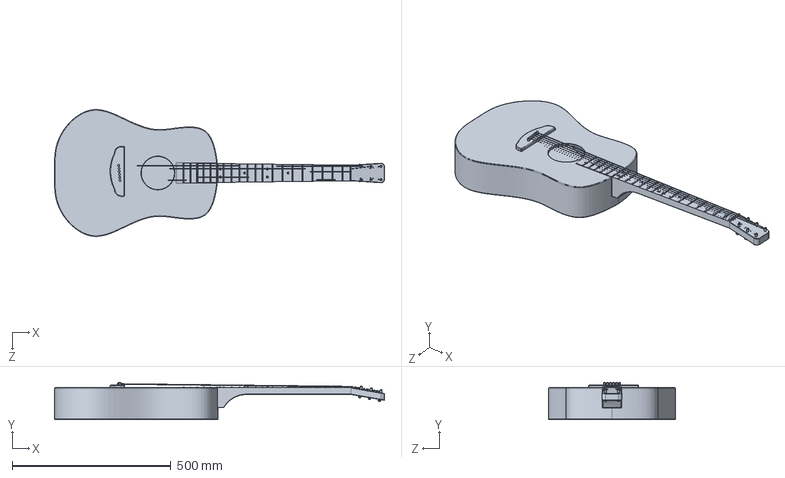
[picture p53: CAD file, 2017-12-18]
Solid Works/Strummer/GUITAR_ACOUSTIC.SLDPRT
1039.6 x 117.6 x 399.5 mm
