proctorsdp/breathStrummer/Solid Works/Strummer/ADAFRUIT_FEATHER.SLDPRT

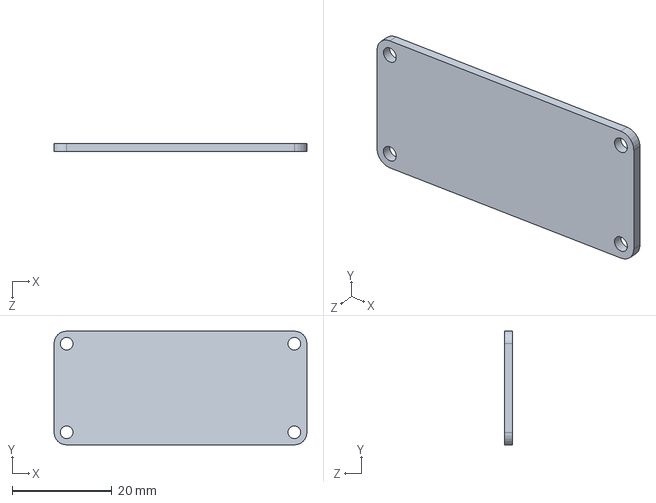
[picture p54: CAD file, 2017-12-18]
Solid Works/Strummer/ADAFRUIT_FEATHER.SLDPRT
50.8 x 22.9 x 1.57 mm
