proctorsdp/breathStrummer/(list of files, cad)

Other CAD files:
Solid Works/Strummer/114_PICK_HOLDER.SLDPRT
STL Files/Strummer/111_LEG_SUPPORT.STL
Solid Works/Mouthpiece/123_MICROPHONE_MOUNT.SLDPRT
Solid Works/Mouthpiece/121_HOUSING_BASE.SLDPRT
Solid Works/Strummer/117_ROD_ADAPTER.SLDPRT
Solid Works/Strummer/116_COVER_MICROPROCESSOR.SLDPRT
Solid Works/Mouthpiece/92470A095_PAN HEAD PHILLIPS SCREW FOR SHEET METAL.SLDPRT
Solid Works/Strummer/115D_D_SHAFT.SLDDRW
Solid Works/Strummer/91772A070_18-8 SS PAN HEAD PHILLIPS MACHINE SCREW.SLDPRT
Solid Works/Strummer/91841A125_TYPE 18-8 STAINLESS STEEL HEX NUT.SLDPRT
Solid Works/Strummer/92470A065_PAN HEAD PHILLIPS SCREW FOR SHEET METAL.SLDPRT
Solid Works/Strummer/92470A095_PAN HEAD PHILLIPS SCREW FOR SHEET METAL.SLDPRT
Solid Works/Strummer/92470A098_PAN HEAD PHILLIPS SCREW FOR SHEET METAL.SLDPRT
Solid Works/Strummer/94639A705_NYLON UNTHRD SPACERS.SLDPRT
Solid Works/Strummer/94639A713_NYLON UNTHRD SPACERS.SLDPRT
Solid Works/Strummer/98410A115_EXTERNAL RETAINING RING.SLDPRT
Solid Works/Strummer/GoPro_Nut.SLDPRT
Solid Works/Strummer/GoPro_Quick_Release_Buckle.SLDPRT
Solid Works/Strummer/GoPro_Thumbscrew_Assembly_Short.SLDASM
Solid Works/Strummer/GoPro_Thumbscrew_Plastic_Short.SLDPRT
Solid Works/Strummer/GoPro_Thumbscrew_Screw_Short.SLDPRT
