proctorsdp/breathStrummer/Drawings/Strummer Schematic.pdf

101

102

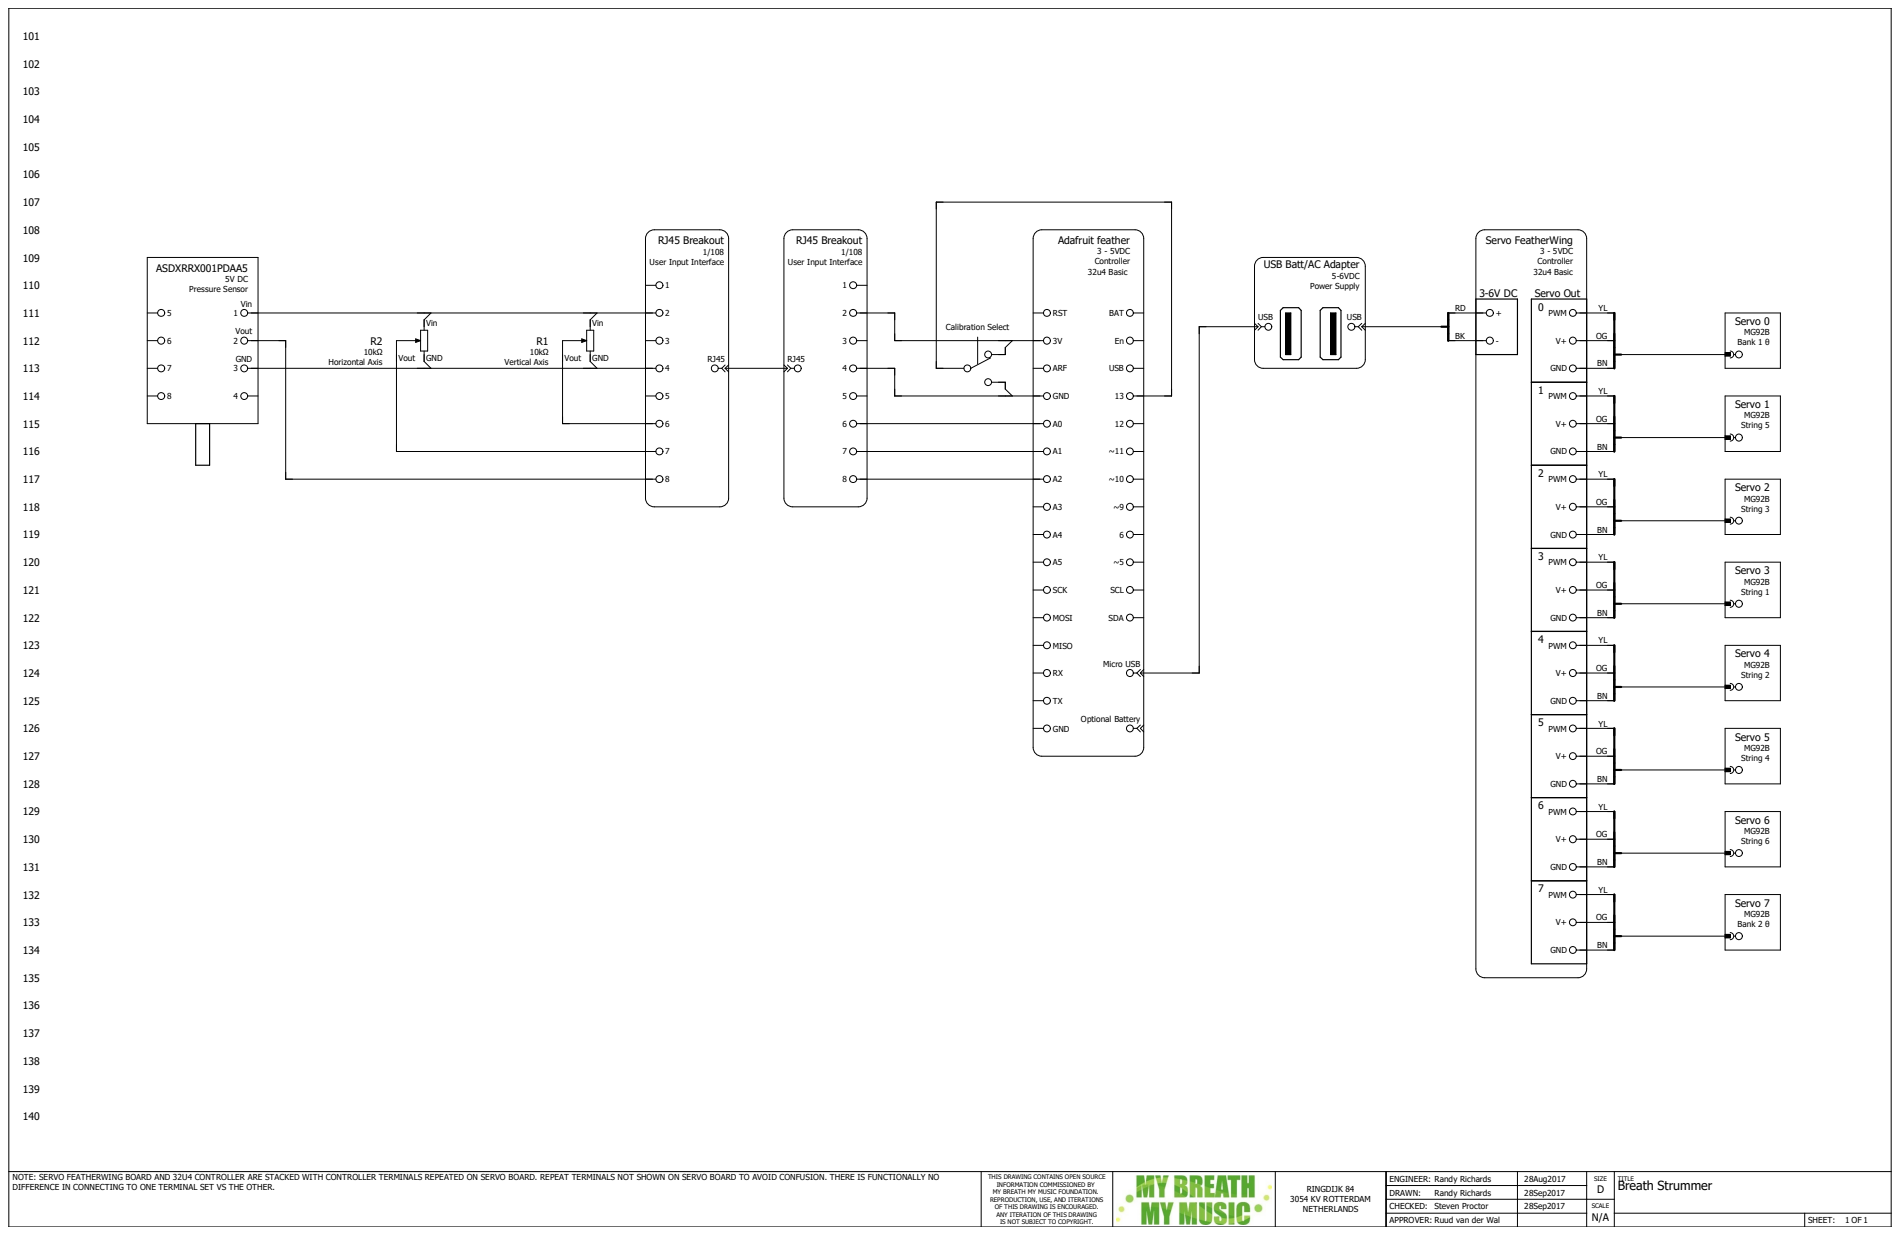
[picture p55: page 1]
YL BNOG; Servo Out RD; BK ASDXRRX001PDAA5 5V DC; 1 Vout 2 GND; 5 Servo 0 MG92B Bank 1 θ Servo 1 MG92B; String 5; Servo 2 MG92B; String 3; Servo 3 MG92B; String 1; Servo 4 MG92B; String 2; Servo 5 MG92B; String 4; Servo 6 MG92B; String 6; Servo 7 MG92B; Bank 2 θ; Power Supply USB; USB Adafruit feather 3 - 5VDC; Controller 32u4 Basic; RST; ARF; GND; SCK; MOSI; MISO; 1 RJ45 RJ45 Breakout 1/108; 3 - 5VDC; - GND; Vin Vout R1; Vin Vout R2; Horizontal Axis; Calibration Select

RJ45 Breakout
User Input Interface 1 2 3 4 5 6 7 8 RJ45

BAT En USB 13 12 ~11 ~10 ~9 6 ~5 SCL SDA Micro USB Optional Battery

Servo FeatherWing
Controller 32u4 Basic PWM V+ GND PWM V+ GND PWM V+ GND PWM V+ GND PWM V+ GND PWM V+ GND PWM V+ GND PWM V+ GND

User Input Interface

USB Batt/AC Adapter 5-6VDC

Pressure Sensor Vin

Vertical Axis GND

DIFFERENCE IN CONNECTING TO ONE TERMINAL SET VS THE OTHER. | THIS DRAWING CONTAINS OPEN SOURCE IS NOT SUBJECT TO COPYRIGHT. INFORMATION COMMISSIONED BY MY BREATH MY MUSIC FOUNDATION. REPRODUCTION, USE, AND ITERATIONS OF THIS DRAWING IS ENCOURAGED. ANY ITERATION OF THIS DRAWING | 3054 KV ROTTERDAM NETHERLANDS | Randy Richards | 28Sep2017 NOTE: SERVO FEATHERWING BOARD AND 32U4 CONTROLLER ARE STACKED WITH CONTROLLER TERMINALS REPEATED ON SERVO BOARD. REPEAT TERMINALS NOT SHOWN ON SERVO BOARD TO AVOID CONFUSION. THERE IS FUNCTIONALLY NO | SCALE SIZE D | OF DRAWN: ENGINEER: CHECKED: APPROVER: RINGDIJK 84 SHEET: TITLE 1 Breath Strummer

Steven Proctor Randy Richards Ruud van der Wal | 28Aug2017 28Sep2017
