proctorsdp/breathStrummer/Drawings/110_STRUMMER.PDF

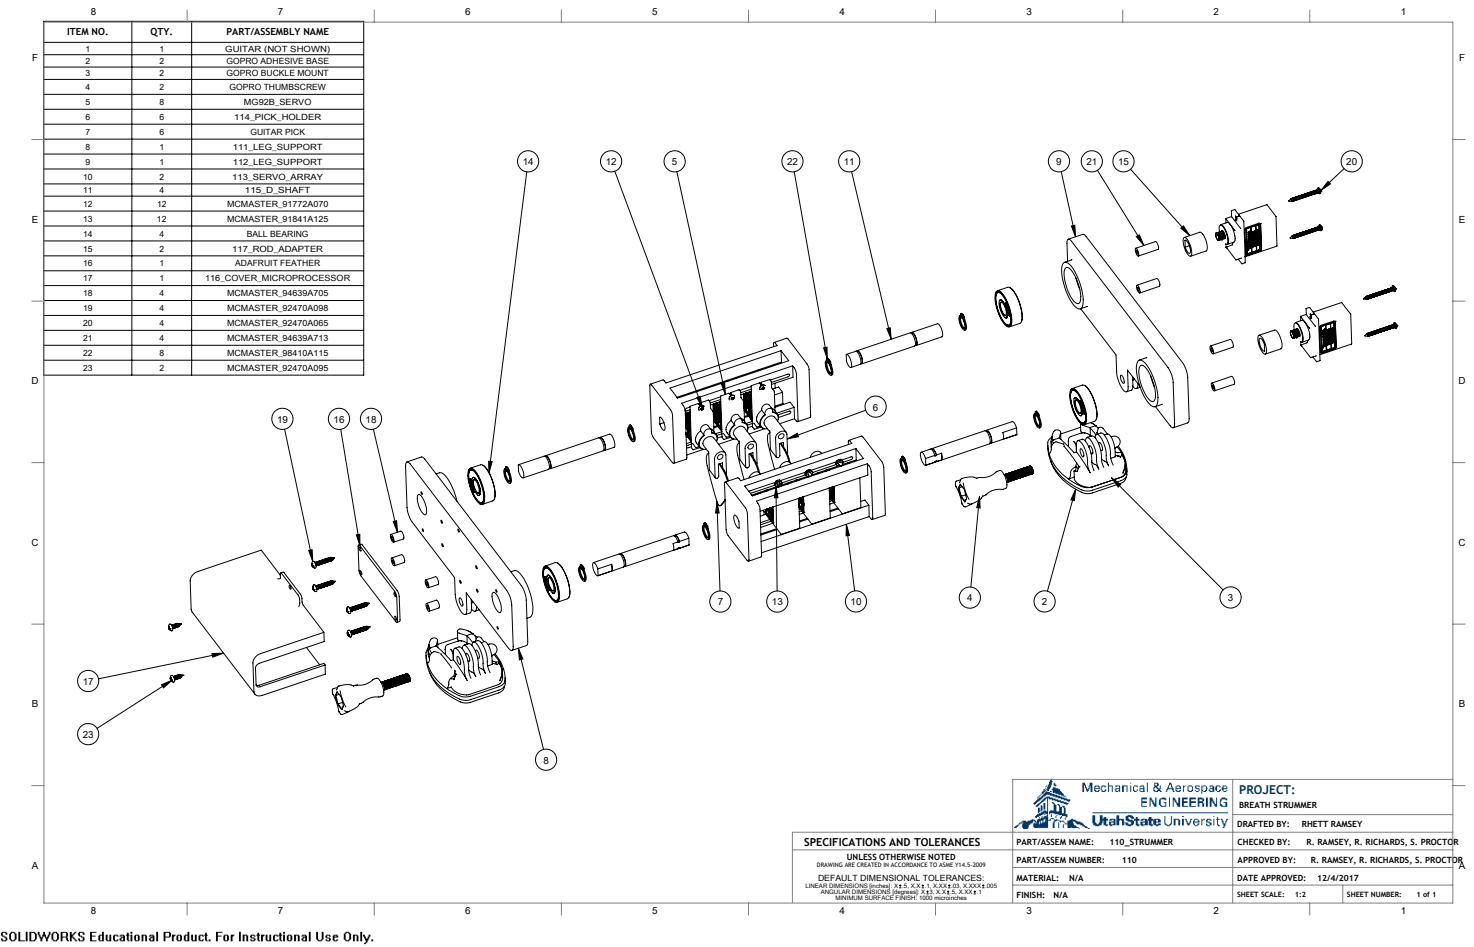
[picture p56: page 1]
DRAFTED BY:; BREATH STRUMMER; R. RAMSEY, R. RICHARDS, S. PROCTOR A

ITEM NO. | QTY. | PART/ASSEMBLY NAME
1 | 1 | GUITAR (NOT SHOWN)
2 | 2 | GOPRO ADHESIVE BASE
3 | 2 | GOPRO BUCKLE MOUNT
4 | 2 | GOPRO THUMBSCREW
5 | 8 | MG92B_SERVO
6 | 6 | 114_PICK_HOLDER
7 8 | 6 1 | GUITAR PICK 111_LEG_SUPPORT

9 | 1 | 112_LEG_SUPPORT
10 | 2 | 113_SERVO_ARRAY
11 | 4 | 115_D_SHAFT
12 | 12 | MCMASTER_91772A070
13 | 12 | MCMASTER_91841A125
14 | 4 | BALL BEARING
15 | 2 | 117_ROD_ADAPTER
16 | 1 | ADAFRUIT FEATHER
17 | 1 | 116_COVER_MICROPROCESSOR
18 19 | 4 4 | MCMASTER_94639A705 MCMASTER_92470A098

20 | 4 | MCMASTER_92470A065
21 | 4 | MCMASTER_94639A713
22 | 8 | MCMASTER_98410A115
23 | 2 | MCMASTER_92470A095

RHETT RAMSEY
R. RAMSEY, R. RICHARDS, S. PROCTOR

SPECIFICATIONS AND TOLERANCES | PART/ASSEM NAME: 110_STRUMMER | CHECKED BY:
UNLESS OTHERWISE NOTED DRAWING ARE CREATED IN ACCORDANCE TO ASME Y14.5-2009 DEFAULT DIMENSIONAL TOLERANCES: LINEAR DIMENSIONS [inches]: X .5, X.X .1, X.XX .03, X.XXX .005 ANGULAR DIMENSIONS [degrees]: X 3, X.X .5, X.XX .1 MINIMUM SURFACE FINISH: 1000 microinches | PART/ASSEM NUMBER: 110 | APPROVED BY:

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
