proctorsdp/breathStrummer/Drawings/120_MOUTHPIECE.PDF

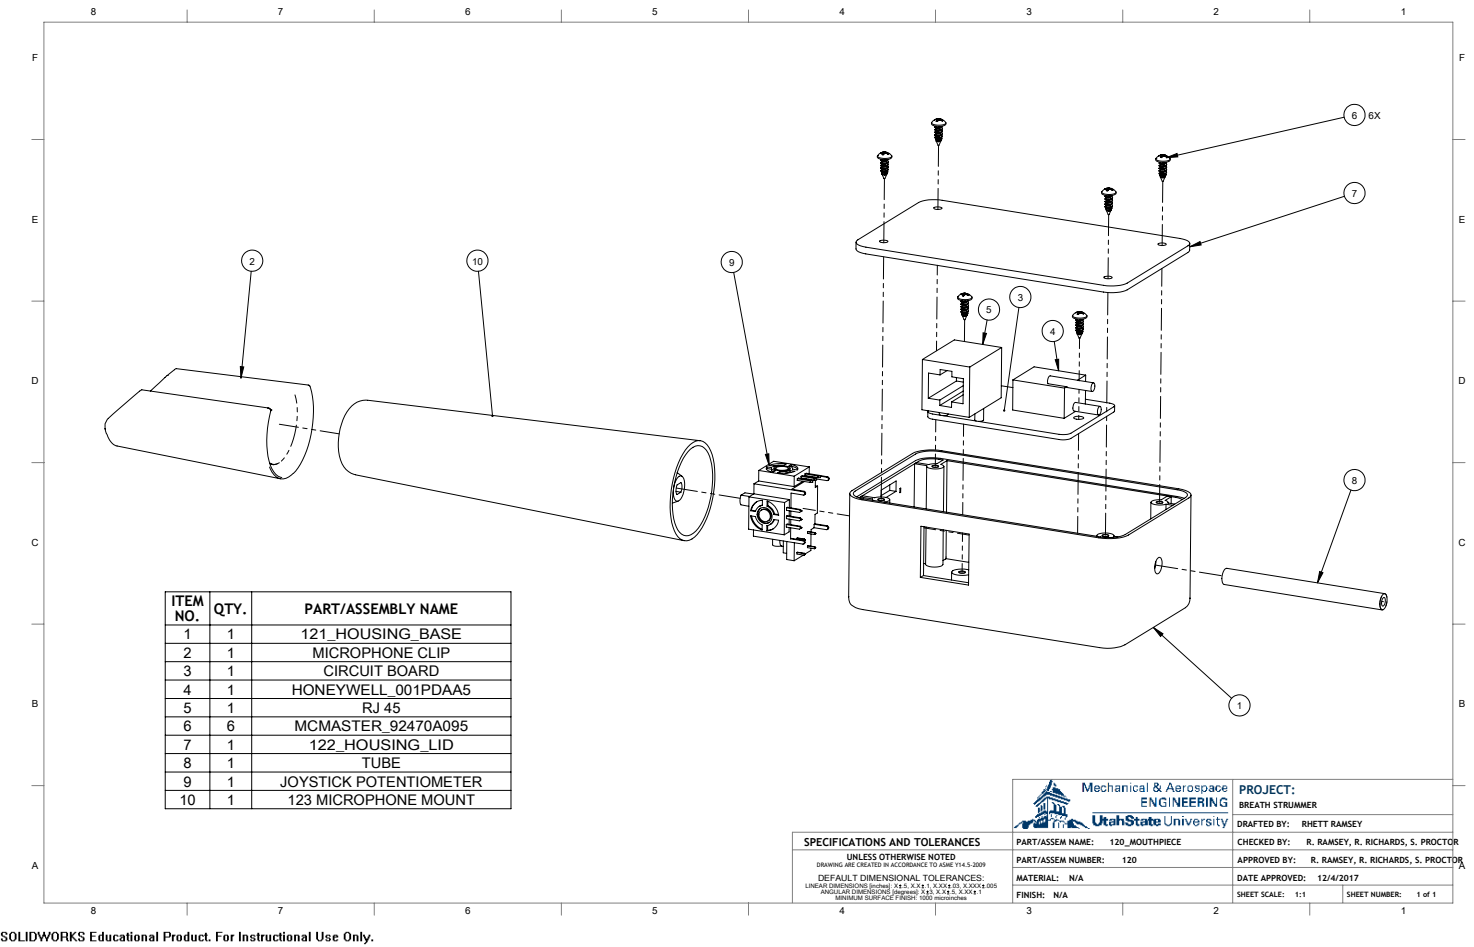
[picture p57: page 1]
123 MICROPHONE MOUNT; PROJECT:; DRAFTED BY:; BREATH STRUMMER; R. RAMSEY, R. RICHARDS, S. PROCTOR A

ITEM NO. | QTY. | PART/ASSEMBLY NAME
1 | 1 | 121_HOUSING_BASE
2 | 1 | MICROPHONE CLIP
3 | 1 | CIRCUIT BOARD
4 | 1 | HONEYWELL_001PDAA5
5 | 1 | RJ 45
6 | 6 | MCMASTER_92470A095
7 | 1 | 122_HOUSING_LID
8 | 1 | TUBE
9 | 1 | JOYSTICK POTENTIOMETER

RHETT RAMSEY
R. RAMSEY, R. RICHARDS, S. PROCTOR

SPECIFICATIONS AND TOLERANCES | PART/ASSEM NAME: 120_MOUTHPIECE | CHECKED BY:
UNLESS OTHERWISE NOTED DRAWING ARE CREATED IN ACCORDANCE TO ASME Y14.5-2009 DEFAULT DIMENSIONAL TOLERANCES: LINEAR DIMENSIONS [inches]: X .5, X.X .1, X.XX .03, X.XXX .005 ANGULAR DIMENSIONS [degrees]: X 3, X.X .5, X.XX .1 MINIMUM SURFACE FINISH: 1000 microinches | PART/ASSEM NUMBER: 120 | APPROVED BY:

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
