proctorsdp/breathStrummer/(commit log)

2017-12-18 Added STL Files
    [111_LEG_SUPPORT.STL, 112_LEG_SUPPORT.STL, 113_SERVO_ARRAY.STL, 114_PICK_HOLDER.STL, 116_COVER_MICROPROCESSOR.STL, 117_ROD_ADAPTER.STL, 121_HOUSING_BASE.STL, 122_HOUSING_LID.STL]
2017-12-18 Added SolidWorks Files
    [110_STRUMMER.SLDASM, 111_LEG_SUPPORT.SLDPRT, 112_LEG_SUPPORT.SLDPRT, 113_SERVO_ARRAY.SLDPRT, 114_PICK_HOLDER.SLDPRT, 115D_D_SHAFT.SLDDRW, 115_D_SHAFT.SLDPRT, 116_COVER_MICROPROCESSOR.SLDPRT]
